Eemac/OlinBAD/Hardware/PowerFet/HIghSidePowerFET.step

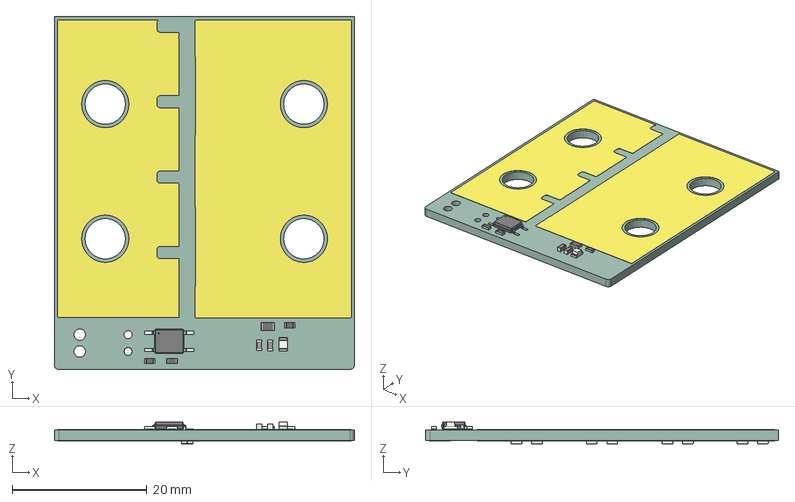
[picture p1: CAD file, 2025-10-27]
Hardware/PowerFet/HIghSidePowerFET.step
44.6 x 52.4 x 3.25 mm
R_0603_1608Metric x 11
R_0805_2012Metric
LED_0805_2012Metric
C_0603_1608Metric x 2
SO_4_44x36mm_P254mm
_autosave-HIghSidePowerFET_zone_1
_autosave-HIghSidePowerFET_zone_2
_autosave-HIghSidePowerFET_zone_3
_autosave-HIghSidePowerFET_zone_4
_autosave-HIghSidePowerFET_zone_5
_autosave-HIghSidePowerFET_PCB
