Eemac/OlinBAD/Hardware/Power Board/Thermistors/Thermistors.kicad_pcb

## KiCad design Hardware/Power Board/Thermistors/Thermistors.kicad_pcb (2025-11-01)

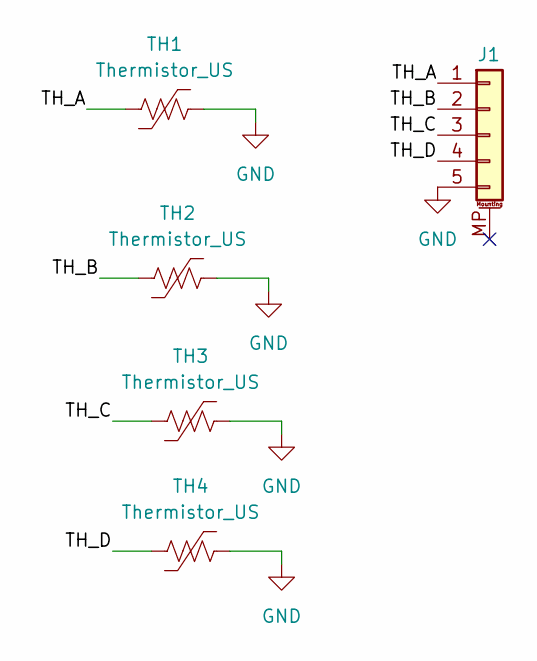
[picture p2: schematic Thermistors.kicad_sch]

Parts:
J1: Conn_01x05_MountingPin; JST_EH_B5B-EH-A_1x05_P2.50mm_Vertical
TH1, TH2, TH3, TH4: Thermistor_US; R_0603_1608Metric

Connections:
/TH_A: J1.1, TH1.1
/TH_B: J1.2, TH2.1
/TH_C: J1.3, TH3.1
/TH_D: J1.4, TH4.1
GND: J1.5, TH1.2, TH2.2, TH3.2, TH4.2

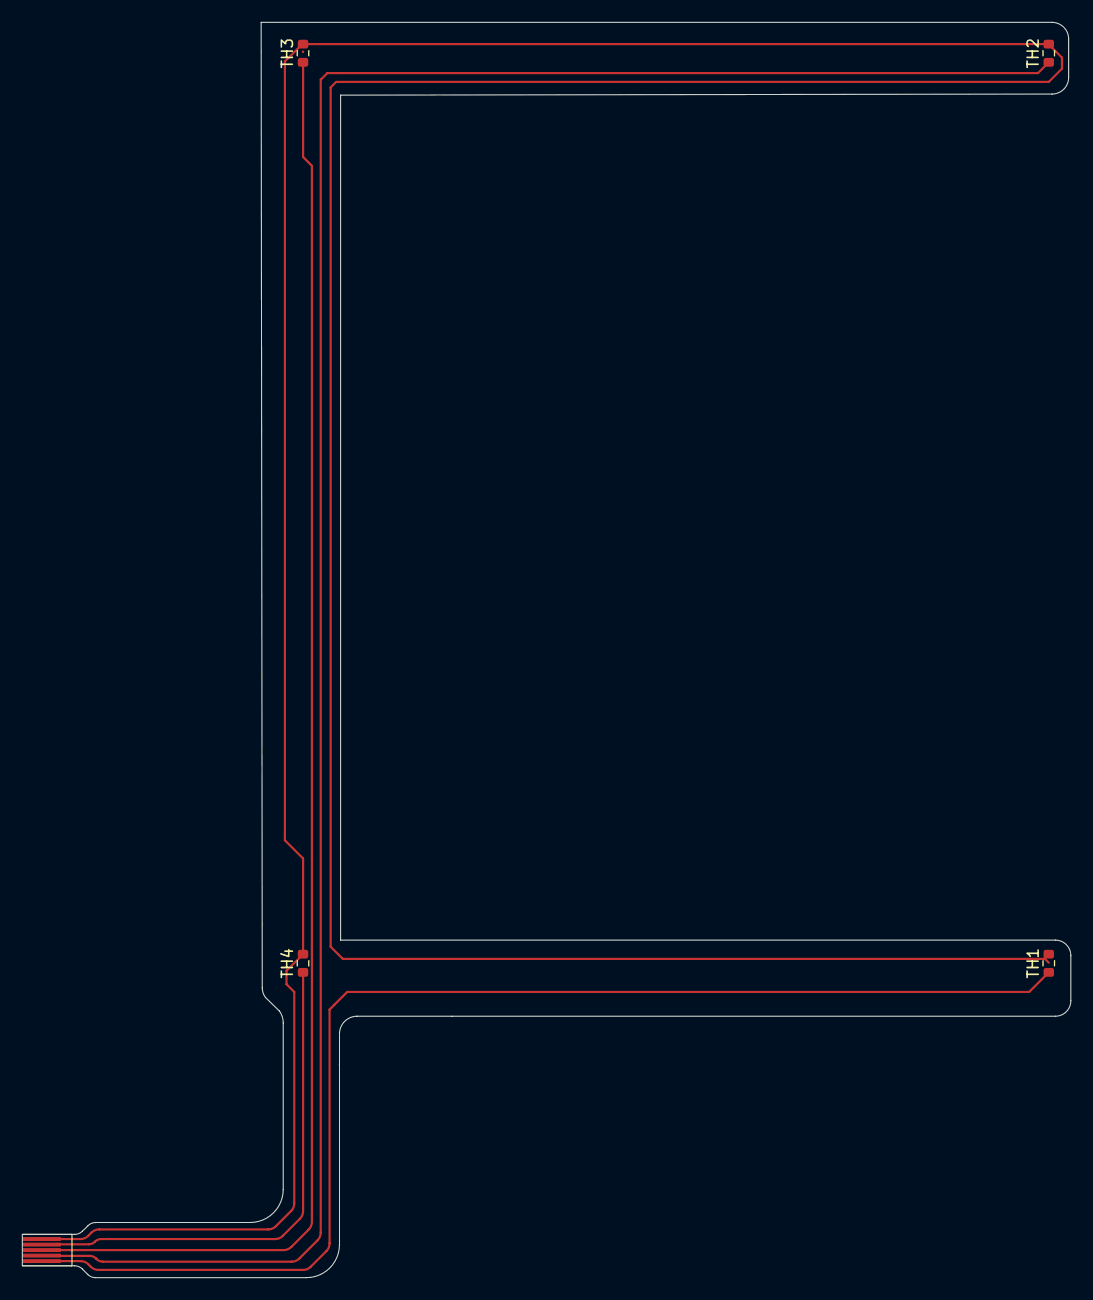
[picture p3: board Thermistors.kicad_pcb from above]

Board: 2 copper layers, 95.0 x 113.8 mm, 5 parts (0 on the bottom side), 5 nets.
