Eemac/OlinBAD/Hardware/BMS/bms.kicad_pcb

## KiCad design Hardware/BMS/bms.kicad_pcb (2025-11-01)

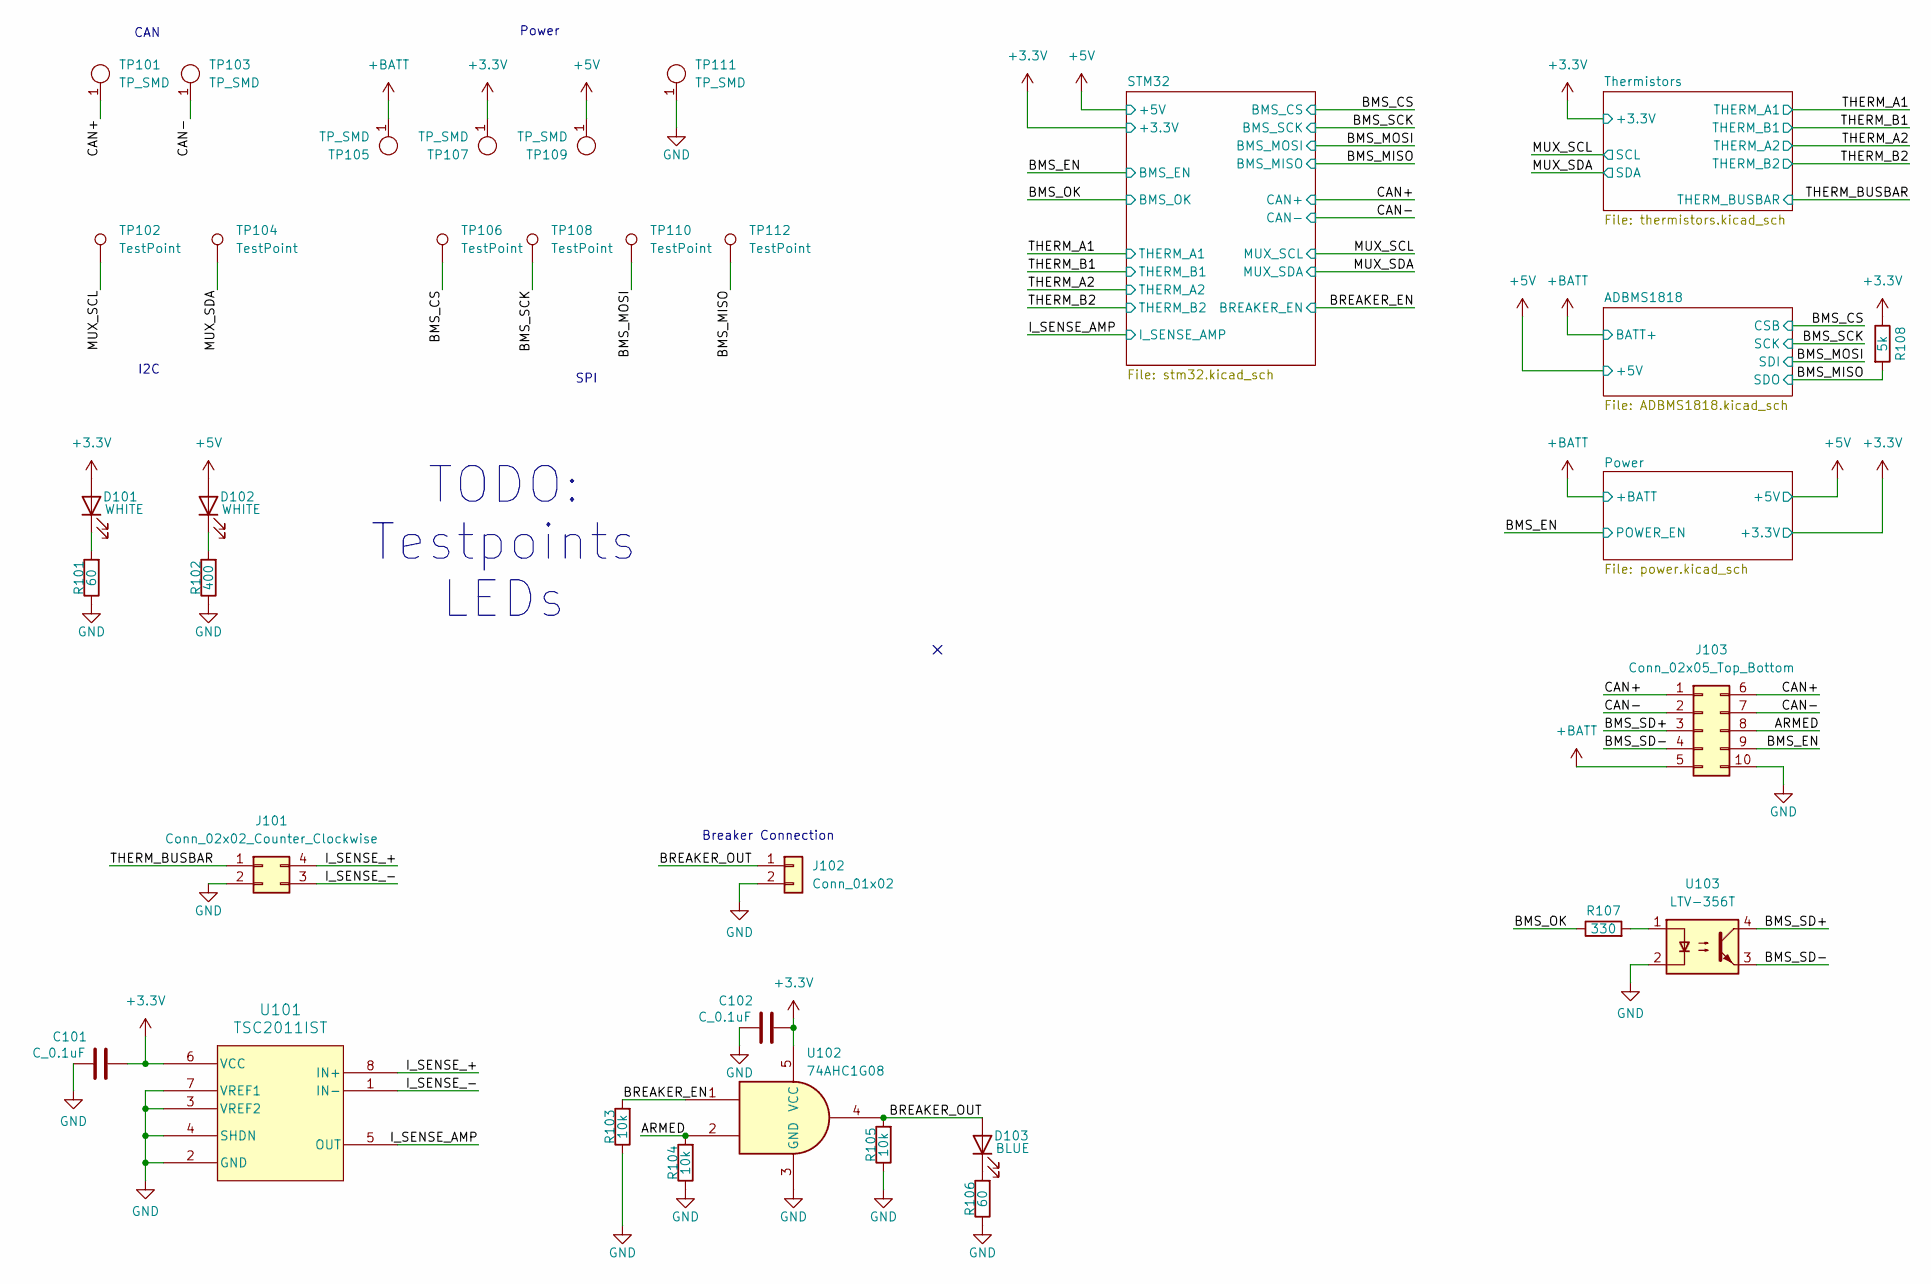
[picture p4: schematic bms.kicad_sch]

Parts:
C101, C102: C_0.1uF; C_0603_1608Metric; MPN 478-3352-1-ND
D101, D102: WHITE; LED_0805_2012Metric
D103: BLUE; LED_0805_2012Metric
J101: Conn_02x02_Counter_Clockwise; Molex_Micro-Fit_3.0_43045-0400_2x02_P3.00mm_Horizontal
J102: Conn_01x02; Molex_Nano-Fit_105313-xx02_1x02_P2.50mm_Horizontal
J103: Conn_02x05_Top_Bottom; Molex_Micro-Fit_3.0_43045-1000_2x05_P3.00mm_Horizontal
R101, R106: 60; R_0603_1608Metric
R102: 400; R_0603_1608Metric
R103, R104, R105: 10k; R_0603_1608Metric
R107: 330; R_0603_1608Metric; MPN RMCF0603FT1K00
R108: 5k; R_0603_1608Metric; MPN RMCF0603FT1K00
TP101, TP103, TP105, TP107, TP109, TP111: TP_SMD; TestPoint_Keystone_5019_Miniature; MPN 5019
TP102, TP104, TP106, TP108, TP110, TP112: TestPoint; TestPoint_Pad_1.0x1.0mm
U101: TSC2011IST; SO_011IST_STM-M
U102: 74AHC1G08; SOT-23-5
U103: LTV-356T; SO-4_4.4x3.6mm_P2.54mm

Connections:
+3.3V: C101.2, C102.2, D101.2 (A), R108.1, TP107.1, U101.6 (VCC), U102.5 (VCC); also elsewhere on the board
+5V: D102.2 (A), TP109.1; also elsewhere on the board
+BATT: J103.5, TP105.1; also elsewhere on the board
/ARMED: J103.8, R104.2, U102.2
/BMS_CS: TP106.1; also elsewhere on the board
/BMS_EN: J103.9; also elsewhere on the board
/BMS_MISO: R108.2, TP112.1; also elsewhere on the board
/BMS_MOSI: TP110.1; also elsewhere on the board
/BMS_OK: R107.1; also elsewhere on the board
/BMS_SCK: TP108.1; also elsewhere on the board
/BMS_SD+: J103.3, U103.4
/BMS_SD-: J103.4, U103.3
/BREAKER_EN: R103.2, U102.1; also elsewhere on the board
/BREAKER_OUT: D103.2 (A), J102.1, R105.2, U102.4
/CAN+: J103.1, J103.6, TP101.1; also elsewhere on the board
/CAN-: J103.2, J103.7, TP103.1; also elsewhere on the board
/I_SENSE_+: J101.4, U101.8 (IN+)
/I_SENSE_-: J101.3, U101.1 (IN-)
/I_SENSE_AMP: U101.5 (OUT); also elsewhere on the board
/MUX_SCL: TP102.1; also elsewhere on the board
/MUX_SDA: TP104.1; also elsewhere on the board
/THERM_BUSBAR: J101.1; also elsewhere on the board
GND: C101.1, C102.1, J101.2, J102.2, J103.10, R101.1, R102.1, R103.1, R104.1, R105.1, R106.1, TP111.1, U101.2 (GND), U101.3 (VREF2), U101.4 (SHDN), U101.7 (VREF1), U102.3 (GND), U103.2; also elsewhere on the board
unnamed: D101.1 (K), R101.2
unnamed: D102.1 (K), R102.2
unnamed: D103.1 (K), R106.2
unnamed: R107.2, U103.1

Notes on the sheet:
I2C
CAN
TODO: Testpoints LEDs
SPI
Breaker Connection
Power

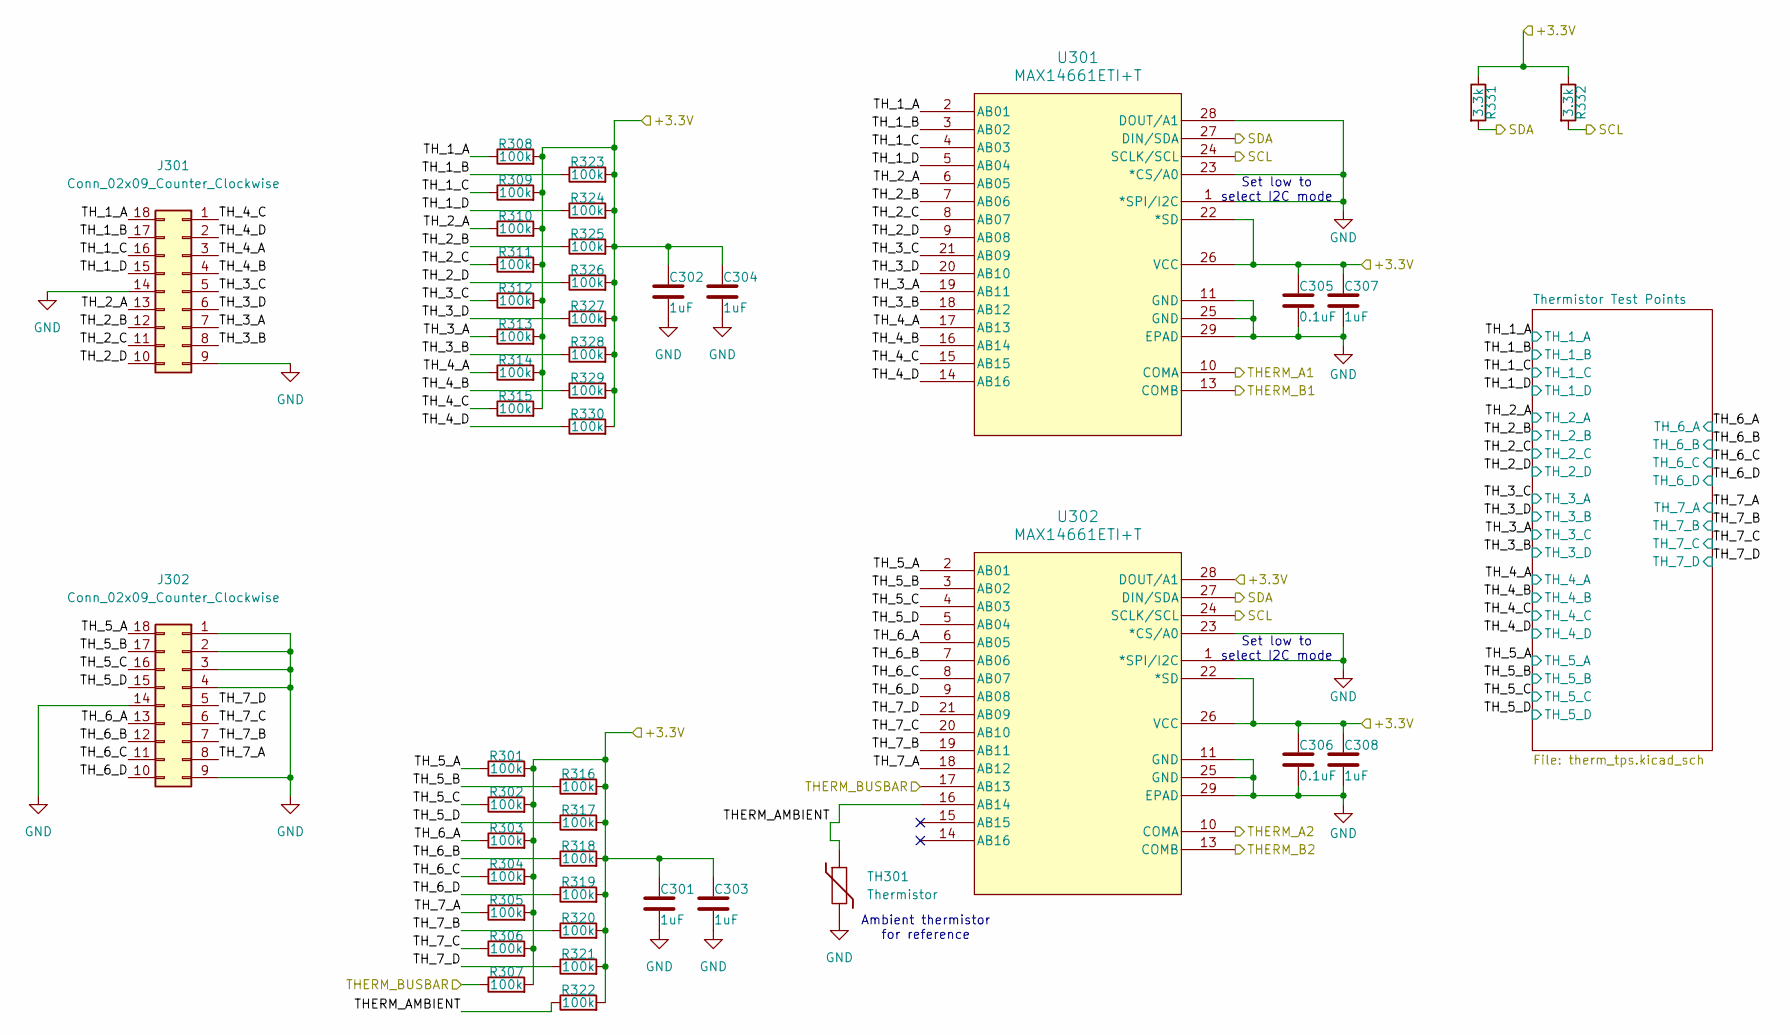
[picture p5: schematic thermistors.kicad_sch]

Parts:
C301, C302, C303, C304, C307, C308: 1uF; C_0603_1608Metric
C305, C306: 0.1uF; C_0603_1608Metric
J301, J302: Conn_02x09_Counter_Clockwise; PinSocket_2x09_P2.54mm_Vertical
R301, R302, R303, R304, R305, R306, R307, R308, R309, R310, R311, R312, R313, R314, R315, R316, R317, R318, R319, R320, R321, R322, R323, R324, R325, R326, R327, R328, R329, R330: 100k; R_0603_1608Metric
R331, R332: 3.3k; R_0603_1608Metric
TH301: Thermistor; R_0603_1608Metric
U301, U302: MAX14661ETI+T; 21-0139I_T2844-1_MXM

Connections:
+3.3V: C301.1, C302.1, C303.1, C304.1, C305.1, C306.1, C307.1, C308.1, R301.2, R302.2, R303.2, R304.2, R305.2, R306.2, R307.2, R308.2, R309.2, R310.2, R311.2, R312.2, R313.2, R314.2, R315.2, R316.2, R317.2, R318.2, R319.2, R320.2, R321.2, R322.2, R323.2, R324.2, R325.2, R326.2, R327.2, R328.2, R329.2, R330.2, R331.1, R332.1, U301.22 (*SD), U301.26 (VCC), U302.22 (*SD), U302.26 (VCC), U302.28 (DOUT/A1); also elsewhere on the board
/MUX_SCL: R332.2, U301.24 (SCLK/SCL), U302.24 (SCLK/SCL); also elsewhere on the board
/MUX_SDA: R331.2, U301.27 (DIN/SDA), U302.27 (DIN/SDA); also elsewhere on the board
/THERM_A1: U301.10 (COMA); also elsewhere on the board
/THERM_A2: U302.10 (COMA); also elsewhere on the board
/THERM_B1: U301.13 (COMB); also elsewhere on the board
/THERM_B2: U302.13 (COMB); also elsewhere on the board
/THERM_BUSBAR: R307.1, U302.17 (AB13); also elsewhere on the board
/Thermistors/THERM_AMBIENT: R322.1, TH301.1, U302.16 (AB14)
/Thermistors/TH_1_A: J301.18, R308.1, U301.2 (AB01); also elsewhere on the board
/Thermistors/TH_1_B: J301.17, R323.1, U301.3 (AB02); also elsewhere on the board
/Thermistors/TH_1_C: J301.16, R309.1, U301.4 (AB03); also elsewhere on the board
/Thermistors/TH_1_D: J301.15, R324.1, U301.5 (AB04); also elsewhere on the board
/Thermistors/TH_2_A: J301.13, R310.1, U301.6 (AB05); also elsewhere on the board
/Thermistors/TH_2_B: J301.12, R325.1, U301.7 (AB06); also elsewhere on the board
/Thermistors/TH_2_C: J301.11, R311.1, U301.8 (AB07); also elsewhere on the board
/Thermistors/TH_2_D: J301.10, R326.1, U301.9 (AB08); also elsewhere on the board
/Thermistors/TH_3_A: J301.7, R313.1, U301.19 (AB11); also elsewhere on the board
/Thermistors/TH_3_B: J301.8, R328.1, U301.18 (AB12); also elsewhere on the board
/Thermistors/TH_3_C: J301.5, R312.1, U301.21 (AB09); also elsewhere on the board
/Thermistors/TH_3_D: J301.6, R327.1, U301.20 (AB10); also elsewhere on the board
/Thermistors/TH_4_A: J301.3, R314.1, U301.17 (AB13); also elsewhere on the board
/Thermistors/TH_4_B: J301.4, R329.1, U301.16 (AB14); also elsewhere on the board
/Thermistors/TH_4_C: J301.1, R315.1, U301.15 (AB15); also elsewhere on the board
/Thermistors/TH_4_D: J301.2, R330.1, U301.14 (AB16); also elsewhere on the board
/Thermistors/TH_5_A: J302.18, R301.1, U302.2 (AB01); also elsewhere on the board
/Thermistors/TH_5_B: J302.17, R316.1, U302.3 (AB02); also elsewhere on the board
/Thermistors/TH_5_C: J302.16, R302.1, U302.4 (AB03); also elsewhere on the board
/Thermistors/TH_5_D: J302.15, R317.1, U302.5 (AB04); also elsewhere on the board
/Thermistors/TH_6_A: J302.13, R303.1, U302.6 (AB05); also elsewhere on the board
/Thermistors/TH_6_B: J302.12, R318.1, U302.7 (AB06); also elsewhere on the board
/Thermistors/TH_6_C: J302.11, R304.1, U302.8 (AB07); also elsewhere on the board
/Thermistors/TH_6_D: J302.10, R319.1, U302.9 (AB08); also elsewhere on the board
/Thermistors/TH_7_A: J302.8, R305.1, U302.18 (AB12); also elsewhere on the board
/Thermistors/TH_7_B: J302.7, R320.1, U302.19 (AB11); also elsewhere on the board
/Thermistors/TH_7_C: J302.6, R306.1, U302.20 (AB10); also elsewhere on the board
/Thermistors/TH_7_D: J302.5, R321.1, U302.21 (AB09); also elsewhere on the board
GND: C301.2, C302.2, C303.2, C304.2, C305.2, C306.2, C307.2, C308.2, J301.9, J301.14, J302.1, J302.2, J302.3, J302.4, J302.9, J302.14, TH301.2, U301.1 (*SPI/I2C), U301.11 (GND), U301.23 (*CS/A0), U301.25 (GND), U301.28 (DOUT/A1), U301.29 (EPAD), U302.1 (*SPI/I2C), U302.11 (GND), U302.23 (*CS/A0), U302.25 (GND), U302.29 (EPAD); also elsewhere on the board

Notes on the sheet:
Set low to select I2C mode
Ambient thermistor for reference

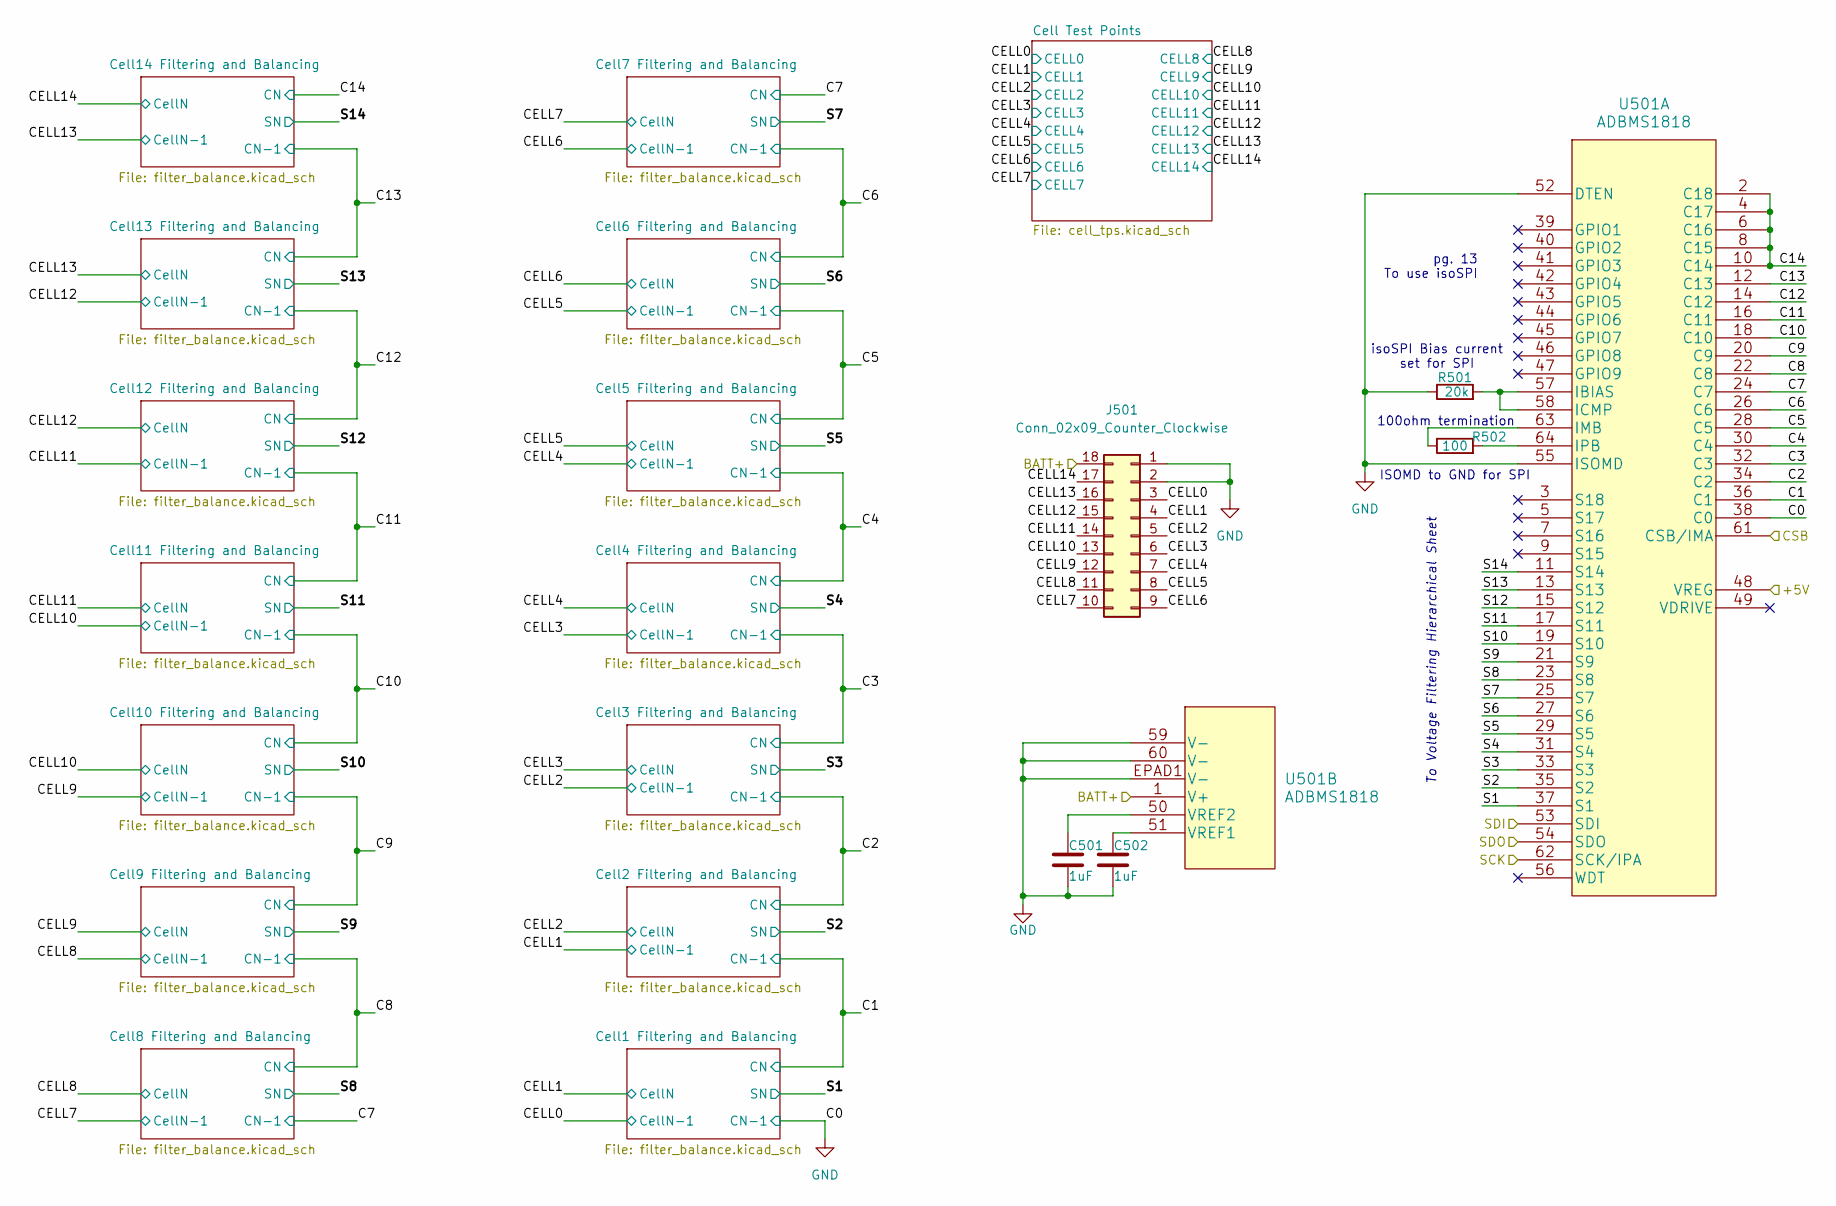
[picture p6: schematic ADBMS1818.kicad_sch]

Parts:
C501, C502: 1uF; C_0603_1608Metric
J501: Conn_02x09_Counter_Clockwise; PinSocket_2x09_P2.54mm_Vertical
R501: 20k; R_0603_1608Metric; MPN RMCF0603FT1K00
R502: 100; R_0603_1608Metric; MPN RMCF0603FT1K00
U501: ADBMS1818; LQFP-64-1EP_12x12_P0.5

Connections:
+5V: U501.48 (VREG); also elsewhere on the board
+BATT: J501.18, U501.1 (V+); also elsewhere on the board
/ADBMS1818/C1: J501.4, U501.36 (C1); also elsewhere on the board
/ADBMS1818/C2: J501.5, U501.34 (C2); also elsewhere on the board
/ADBMS1818/C3: J501.6, U501.32 (C3); also elsewhere on the board
/ADBMS1818/C4: J501.7, U501.30 (C4); also elsewhere on the board
/ADBMS1818/C5: J501.8, U501.28 (C5); also elsewhere on the board
/ADBMS1818/C6: J501.9, U501.26 (C6); also elsewhere on the board
/ADBMS1818/C7: J501.10, U501.24 (C7); also elsewhere on the board
/ADBMS1818/C8: J501.11, U501.22 (C8); also elsewhere on the board
/ADBMS1818/C9: J501.12, U501.20 (C9); also elsewhere on the board
/ADBMS1818/C10: J501.13, U501.18 (C10); also elsewhere on the board
/ADBMS1818/C11: J501.14, U501.16 (C11); also elsewhere on the board
/ADBMS1818/C12: J501.15, U501.14 (C12); also elsewhere on the board
/ADBMS1818/C13: J501.16, U501.12 (C13); also elsewhere on the board
/ADBMS1818/C14: U501.2 (C18), U501.4 (C17), U501.6 (C16), U501.8 (C15), U501.10 (C14); also elsewhere on the board
/ADBMS1818/CELL14: J501.17; also elsewhere on the board
/ADBMS1818/S1: U501.37 (S1); also elsewhere on the board
/ADBMS1818/S2: U501.35 (S2); also elsewhere on the board
/ADBMS1818/S3: U501.33 (S3); also elsewhere on the board
/ADBMS1818/S4: U501.31 (S4); also elsewhere on the board
/ADBMS1818/S5: U501.29 (S5); also elsewhere on the board
/ADBMS1818/S6: U501.27 (S6); also elsewhere on the board
/ADBMS1818/S7: U501.25 (S7); also elsewhere on the board
/ADBMS1818/S8: U501.23 (S8); also elsewhere on the board
/ADBMS1818/S9: U501.21 (S9); also elsewhere on the board
/ADBMS1818/S10: U501.19 (S10); also elsewhere on the board
/ADBMS1818/S11: U501.17 (S11); also elsewhere on the board
/ADBMS1818/S12: U501.15 (S12); also elsewhere on the board
/ADBMS1818/S13: U501.13 (S13); also elsewhere on the board
/ADBMS1818/S14: U501.11 (S14); also elsewhere on the board
/BMS_CS: U501.61 (CSB/IMA); also elsewhere on the board
/BMS_MISO: U501.54 (SDO); also elsewhere on the board
/BMS_MOSI: U501.53 (SDI); also elsewhere on the board
/BMS_SCK: U501.62 (SCK/IPA); also elsewhere on the board
GND: C501.2, C502.2, J501.1, J501.2, J501.3, R501.1, U501.38 (C0), U501.52 (DTEN), U501.55 (ISOMD), U501.59 (V-), U501.60 (V-), U501.EPAD1 (V-); also elsewhere on the board
unnamed: R501.2, U501.57 (IBIAS), U501.58 (ICMP)
unnamed: R502.1, U501.63 (IMB)
unnamed: R502.2, U501.64 (IPB)
unnamed: C502.1, U501.51 (VREF1)
unnamed: C501.1, U501.50 (VREF2)

Notes on the sheet:
100ohm termination
pg. 13 To use isoSPI
ISOMD to GND for SPI
isoSPI Bias current set for SPI
To Voltage Filtering Hierarchical Sheet

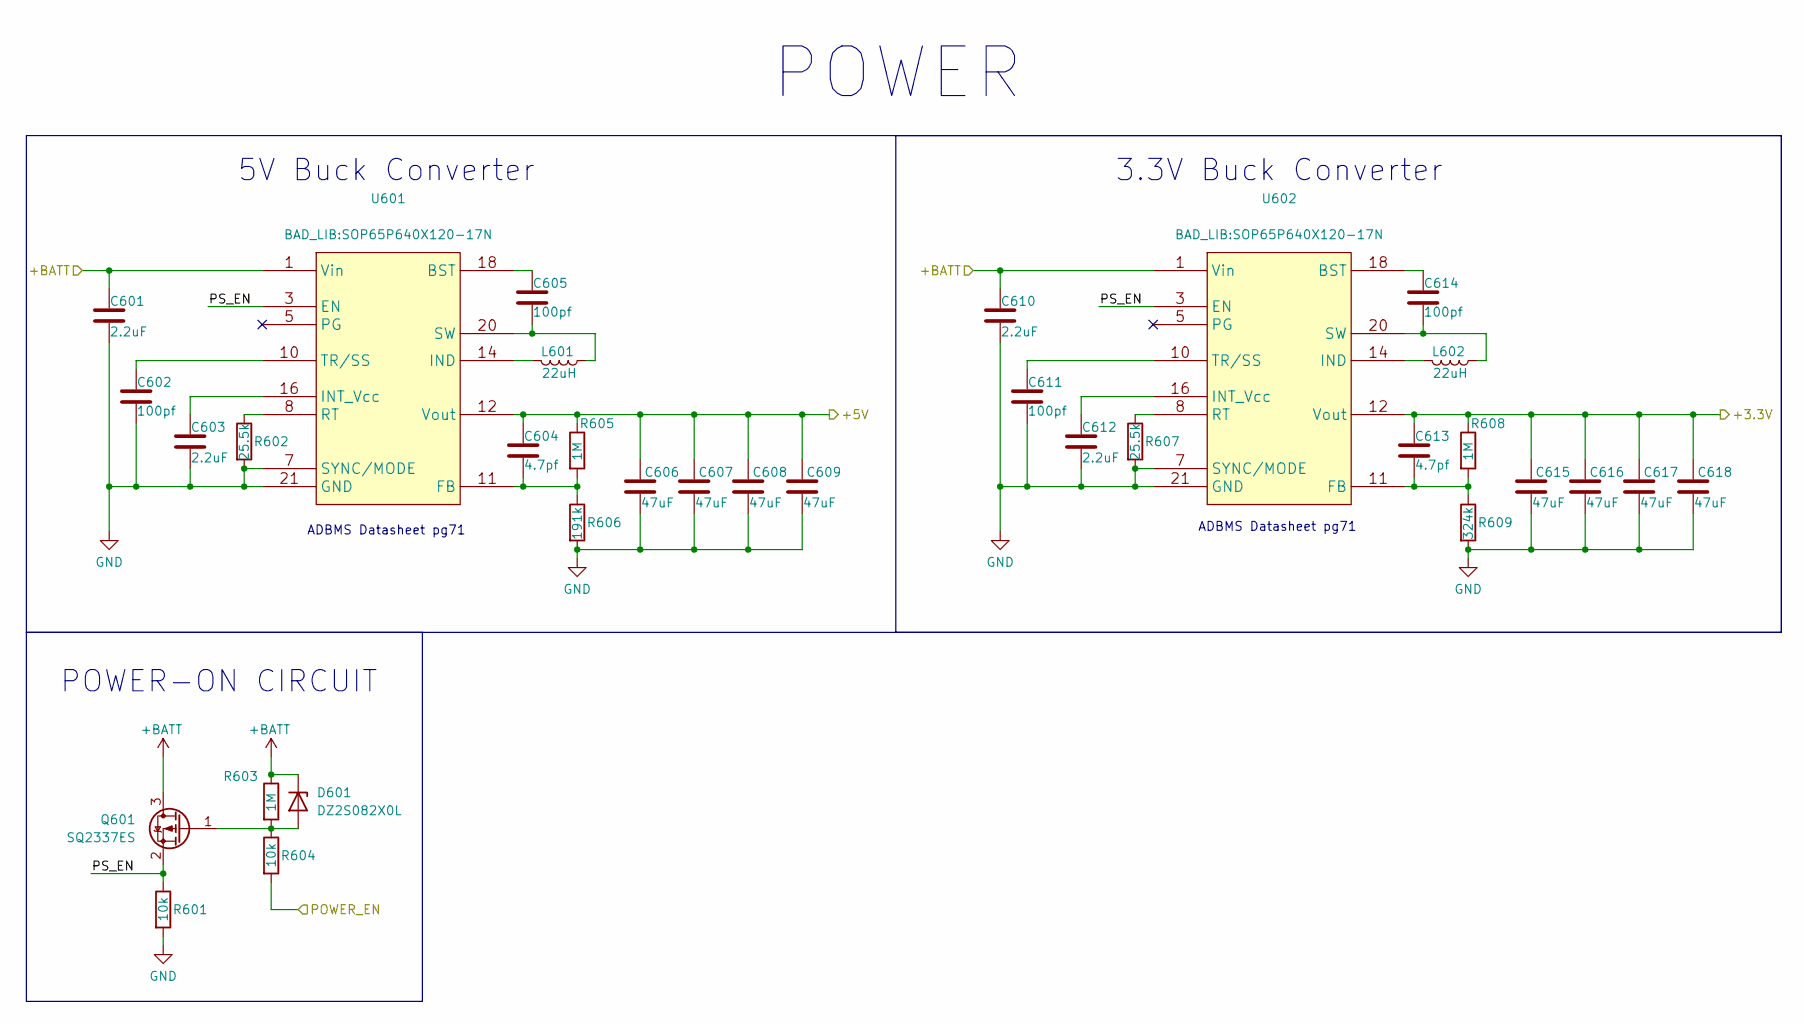
[picture p7: schematic power.kicad_sch]

Parts:
C601, C603, C610, C612: 2.2uF; C_0603_1608Metric
C602, C605, C611, C614: 100pf; C_0603_1608Metric
C604, C613: 4.7pf; C_0603_1608Metric
C606, C607, C608, C609, C615, C616, C617, C618: 47uF; C_1206_3216Metric
D601: DZ2S082X0L; D_SOD-523
L601, L602: 22uH; L_12x12mm_H4.5mm
Q601: SQ2337ES; SOT-23
R601, R604: 10k; R_0603_1608Metric
R602, R607: 25.5k; R_0603_1608Metric
R603, R605, R608: 1M; R_0603_1608Metric
R606: 191k; R_0603_1608Metric
R609: 324k; R_0603_1608Metric
U601, U602: SOP65P640X120-17N

Connections:
+3.3V: C613.1, C615.1, C616.1, C617.1, C618.1, R608.1, U602.12 (Vout); also elsewhere on the board
+5V: C604.1, C606.1, C607.1, C608.1, C609.1, R605.1, U601.12 (Vout); also elsewhere on the board
+BATT: C601.1, C610.1, D601.1 (K), Q601.3 (D), R603.1, U601.1 (Vin), U602.1 (Vin); also elsewhere on the board
/BMS_EN: R604.2; also elsewhere on the board
/Power/PS_EN: Q601.2 (S), R601.1, U601.3 (EN), U602.3 (EN)
GND: C601.2, C602.2, C603.2, C606.2, C607.2, C608.2, C609.2, C610.2, C611.2, C612.2, C615.2, C616.2, C617.2, C618.2, R601.2, R602.2, R606.2, R607.2, R609.2, U601.7 (SYNC/MODE), U601.21 (GND), U602.7 (SYNC/MODE), U602.21 (GND); also elsewhere on the board
unnamed: D601.2 (A), Q601.1 (G), R603.2, R604.1
unnamed: C605.1, U601.18 (BST)
unnamed: C604.2, R605.2, R606.1, U601.11 (FB)
unnamed: L601.2, U601.14 (IND)
unnamed: C603.1, U601.16 (INT_Vcc)
unnamed: R602.1, U601.8 (RT)
unnamed: C605.2, L601.1, U601.20 (SW)
unnamed: C602.1, U601.10 (TR/SS)
unnamed: C614.1, U602.18 (BST)
unnamed: C613.2, R608.2, R609.1, U602.11 (FB)
unnamed: L602.2, U602.14 (IND)
unnamed: C612.1, U602.16 (INT_Vcc)
unnamed: R607.1, U602.8 (RT)
unnamed: C614.2, L602.1, U602.20 (SW)
unnamed: C611.1, U602.10 (TR/SS)

Notes on the sheet:
3.3V Buck Converter
ADBMS Datasheet pg71
POWER-ON CIRCUIT
5V Buck Converter
POWER

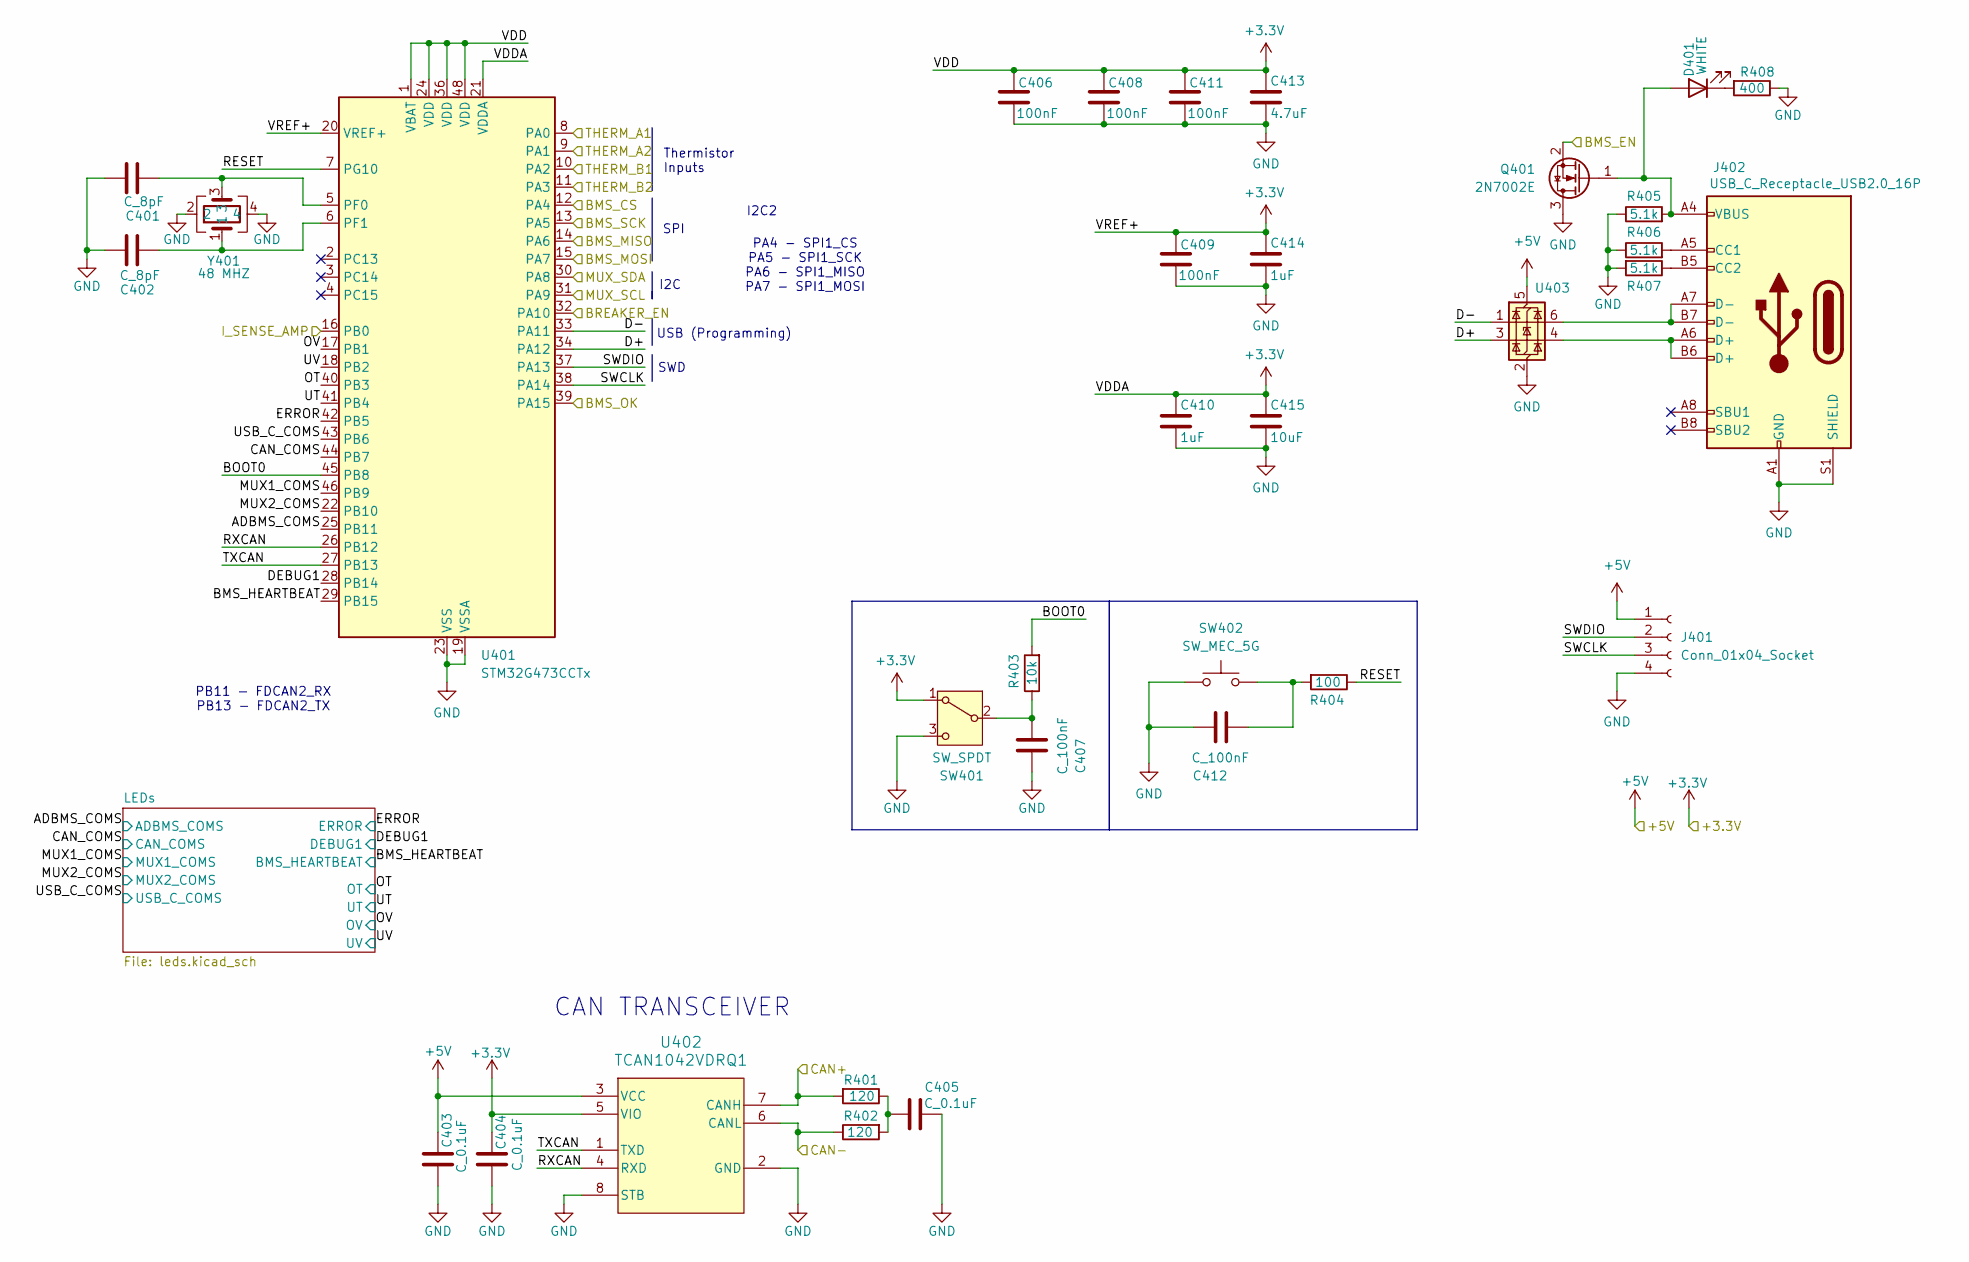
[picture p8: schematic stm32.kicad_sch]

Parts:
C401, C402: C_8pF; C_0603_1608Metric; MPN 1276-6717-1-ND
C403, C404, C405: C_0.1uF; C_0603_1608Metric; MPN 478-3352-1-ND
C406, C408, C409, C411: 100nF; C_0603_1608Metric; MPN 1276-6717-1-ND
C407, C412: C_100nF; C_0603_1608Metric; MPN 1276-6717-1-ND
C410, C414: 1uF; C_0603_1608Metric; MPN 1276-1052-1-ND
C413: 4.7uF; C_0805_2012Metric; MPN 1276-1052-1-ND
C415: 10uF; C_0805_2012Metric; MPN 1276-1052-1-ND
D401: WHITE; LED_0805_2012Metric
J401: Conn_01x04_Socket; PinSocket_1x04_P2.54mm_Vertical
J402: USB_C_Receptacle_USB2.0_16P; USB_C_Receptacle_G-Switch_GT-USB-7051x
Q401: 2N7002E; SOT-23
R401, R402: 120; R_0603_1608Metric; MPN 667-ERJ-6ENF1200V
R403: 10k; R_0805_OEM; MPN CRS0805-FX-1002ELFCT-ND
R404: 100; R_0805_OEM; MPN CRS0805-FX-1002ELFCT-ND
R405, R406, R407: 5.1k; R_0603_1608Metric; MPN RMCF0603FT1K00
R408: 400; R_0603_1608Metric
SW401: SW_SPDT; SW_SPDT_Shouhan_MSK12C02
SW402: SW_MEC_5G; SW_MEC_5GSH9
U401: STM32G473CCTx; LQFP-48_7x7mm_P0.5mm
U402: TCAN1042VDRQ1; D0008A_M
U403: USBLC6-2SC6; SOT-23-6
Y401: 48 MHZ; Crystal_SMD_FA238; MPN 7M48072002

Connections:
+3.3V: C404.1, C406.1, C408.1, C409.1, C410.1, C411.1, C413.1, C414.1, C415.1, SW401.1 (A), U401.1 (VBAT), U401.20 (VREF+), U401.21 (VDDA), U401.24 (VDD), U401.36 (VDD), U401.48 (VDD), U402.5 (VIO); also elsewhere on the board
+5V: C403.1, J401.1, U402.3 (VCC), U403.5 (VBUS); also elsewhere on the board
/BMS_CS: U401.12 (PA4); also elsewhere on the board
/BMS_EN: Q401.2 (S); also elsewhere on the board
/BMS_MISO: U401.14 (PA6); also elsewhere on the board
/BMS_MOSI: U401.15 (PA7); also elsewhere on the board
/BMS_OK: U401.39 (PA15); also elsewhere on the board
/BMS_SCK: U401.13 (PA5); also elsewhere on the board
/BREAKER_EN: U401.32 (PA10); also elsewhere on the board
/CAN+: R401.2, U402.7 (CANH); also elsewhere on the board
/CAN-: R402.1, U402.6 (CANL); also elsewhere on the board
/I_SENSE_AMP: U401.16 (PB0); also elsewhere on the board
/MUX_SCL: U401.31 (PA9); also elsewhere on the board
/MUX_SDA: U401.30 (PA8); also elsewhere on the board
/STM32/ADBMS_COMS: U401.25 (PB11); also elsewhere on the board
/STM32/BMS_HEARTBEAT: U401.29 (PB15); also elsewhere on the board
/STM32/BOOT0: R403.2, U401.45 (PB8)
/STM32/CAN_COMS: U401.44 (PB7); also elsewhere on the board
/STM32/D+: U401.34 (PA12), U403.3 (I/O2)
/STM32/D-: U401.33 (PA11), U403.1 (I/O1)
/STM32/DEBUG1: U401.28 (PB14); also elsewhere on the board
/STM32/ERROR: U401.42 (PB5); also elsewhere on the board
/STM32/MUX1_COMS: U401.46 (PB9); also elsewhere on the board
/STM32/MUX2_COMS: U401.22 (PB10); also elsewhere on the board
/STM32/OT: U401.40 (PB3); also elsewhere on the board
/STM32/OV: U401.17 (PB1); also elsewhere on the board
/STM32/RESET: R404.1, U401.7 (PG10)
/STM32/RXCAN: U401.26 (PB12), U402.4 (RXD)
/STM32/SWCLK: J401.3, U401.38 (PA14)
/STM32/SWDIO: J401.2, U401.37 (PA13)
/STM32/TXCAN: U401.27 (PB13), U402.1 (TXD)
/STM32/USB_C_COMS: U401.43 (PB6); also elsewhere on the board
/STM32/UT: U401.41 (PB4); also elsewhere on the board
/STM32/UV: U401.18 (PB2); also elsewhere on the board
/THERM_A1: U401.8 (PA0); also elsewhere on the board
/THERM_A2: U401.9 (PA1); also elsewhere on the board
/THERM_B1: U401.10 (PA2); also elsewhere on the board
/THERM_B2: U401.11 (PA3); also elsewhere on the board
GND: C401.2, C402.1, C403.2, C404.2, C405.2, C406.2, C407.1, C408.2, C409.2, C410.2, C411.2, C412.1, C413.2, C414.2, C415.2, J401.4, J402.A1 (GND), J402.A12 (GND), J402.B1 (GND), J402.B12 (GND), J402.S1 (SHIELD), Q401.3 (D), R405.1, R406.1, R407.2, R408.1, SW401.3 (C), SW402.1 (A), SW402.2 (A), U401.19 (VSSA), U401.23 (VSS), U401.35 (VSS), U401.47 (VSS), U402.2 (GND), U402.8 (STB), U403.2 (GND), Y401.2, Y401.4; also elsewhere on the board
unnamed: C405.1, R401.1, R402.2
unnamed: C412.2, R404.2, SW402.3 (B), SW402.4 (B)
unnamed: D401.2 (A), J402.A4 (VBUS), J402.A9 (VBUS), J402.B4 (VBUS), J402.B9 (VBUS), Q401.1 (G), R405.2
unnamed: D401.1 (K), R408.2
unnamed: J402.A5 (CC1), R406.2
unnamed: J402.B5 (CC2), R407.1
unnamed: J402.A6 (D+), J402.B6 (D+), U403.4 (I/O2)
unnamed: J402.A7 (D-), J402.B7 (D-), U403.6 (I/O1)
unnamed: C407.2, R403.1, SW401.2 (B)
unnamed: C401.1, U401.5 (PF0), Y401.3
unnamed: C402.2, U401.6 (PF1), Y401.1

Notes on the sheet:
I2C
PA4 - SPI1_CS PA5 - SPI1_SCK PA6 - SPI1_MISO PA7 - SPI1_MOSI
CAN TRANSCEIVER
SWD
SPI
USB (Programming)
I2C2
PB11 - FDCAN2_RX PB13 - FDCAN2_TX
Thermistor Inputs
