Eemac/OlinBAD/Hardware/BMS/bms.kicad_pcb

## KiCad design Hardware/BMS/bms.kicad_pcb (continued)

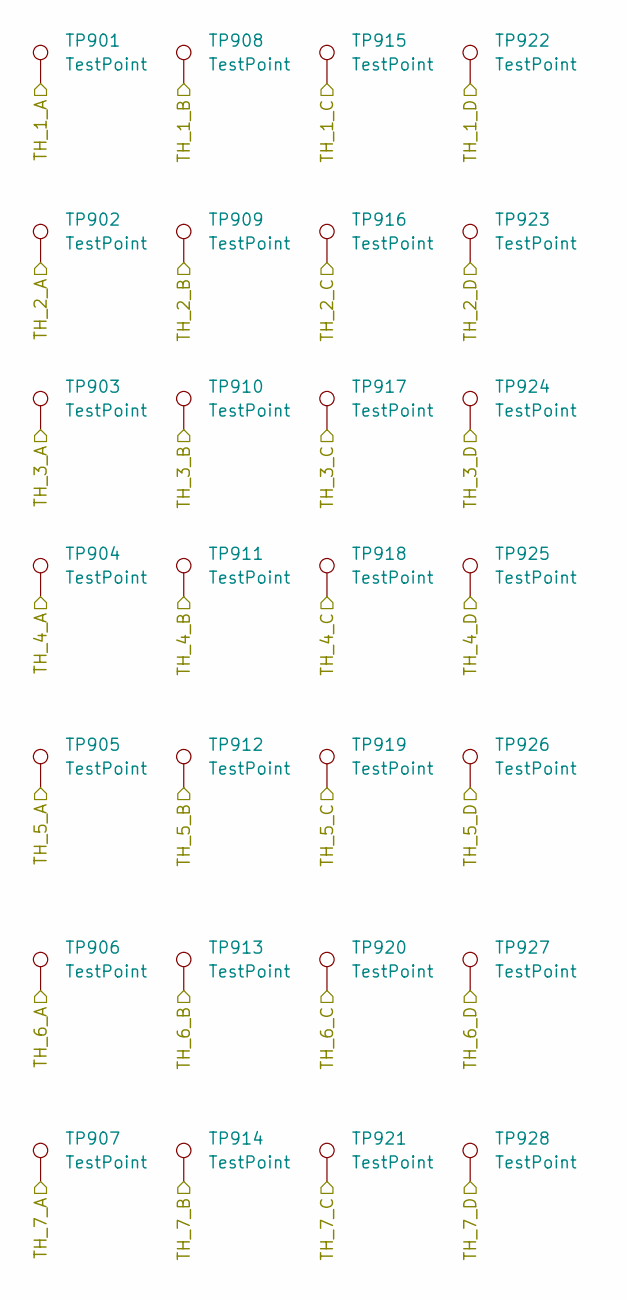
[picture p9: schematic therm_tps.kicad_sch]

Parts:
TP901, TP902, TP903, TP904, TP905, TP906, TP907, TP908, TP909, TP910, TP911, TP912, TP913, TP914, TP915, TP916, TP917, TP918, TP919, TP920, TP921, TP922, TP923, TP924, TP925, TP926, TP927, TP928: TestPoint; TestPoint_Pad_1.0x1.0mm

Connections:
/Thermistors/TH_1_A: TP901.1; also elsewhere on the board
/Thermistors/TH_1_B: TP908.1; also elsewhere on the board
/Thermistors/TH_1_C: TP915.1; also elsewhere on the board
/Thermistors/TH_1_D: TP922.1; also elsewhere on the board
/Thermistors/TH_2_A: TP902.1; also elsewhere on the board
/Thermistors/TH_2_B: TP909.1; also elsewhere on the board
/Thermistors/TH_2_C: TP916.1; also elsewhere on the board
/Thermistors/TH_2_D: TP923.1; also elsewhere on the board
/Thermistors/TH_3_A: TP917.1; also elsewhere on the board
/Thermistors/TH_3_B: TP924.1; also elsewhere on the board
/Thermistors/TH_3_C: TP903.1; also elsewhere on the board
/Thermistors/TH_3_D: TP910.1; also elsewhere on the board
/Thermistors/TH_4_A: TP904.1; also elsewhere on the board
/Thermistors/TH_4_B: TP911.1; also elsewhere on the board
/Thermistors/TH_4_C: TP918.1; also elsewhere on the board
/Thermistors/TH_4_D: TP925.1; also elsewhere on the board
/Thermistors/TH_5_A: TP905.1; also elsewhere on the board
/Thermistors/TH_5_B: TP912.1; also elsewhere on the board
/Thermistors/TH_5_C: TP919.1; also elsewhere on the board
/Thermistors/TH_5_D: TP926.1; also elsewhere on the board
/Thermistors/TH_6_A: TP906.1; also elsewhere on the board
/Thermistors/TH_6_B: TP913.1; also elsewhere on the board
/Thermistors/TH_6_C: TP920.1; also elsewhere on the board
/Thermistors/TH_6_D: TP927.1; also elsewhere on the board
/Thermistors/TH_7_A: TP907.1; also elsewhere on the board
/Thermistors/TH_7_B: TP914.1; also elsewhere on the board
/Thermistors/TH_7_C: TP921.1; also elsewhere on the board
/Thermistors/TH_7_D: TP928.1; also elsewhere on the board

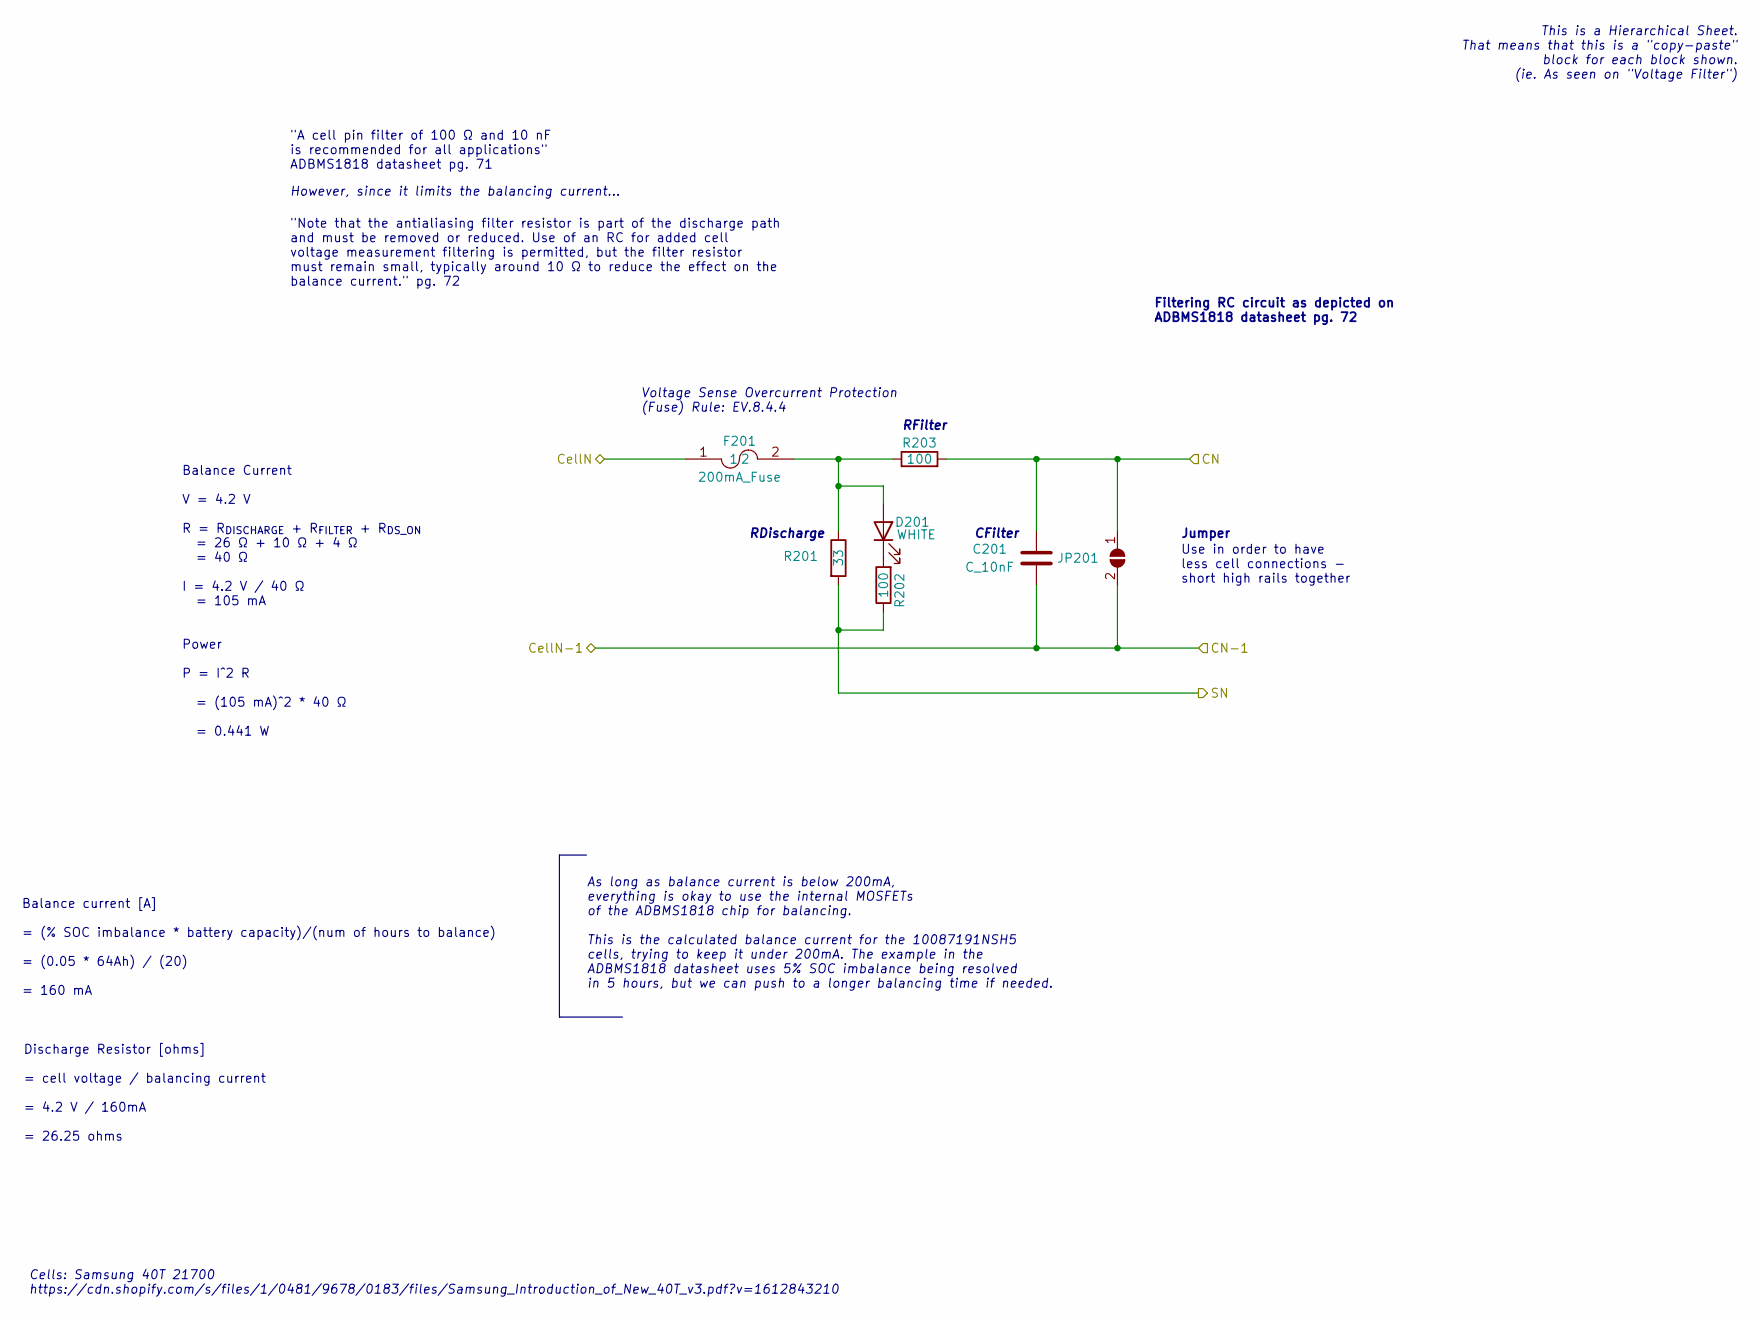
[picture p10: schematic filter_balance.kicad_sch]

Parts:
C201: C_10nF; C_0603_1608Metric; MPN CL10B103KB8NNNC
D201: WHITE; LED_0805_2012Metric
F201: 200mA_Fuse; Fuse_1206_3216Metric; MPN 0466.200NRHF
JP201: SolderJumper_2_Open; SolderJumper-2_P1.3mm_Open_TrianglePad1.0x1.5mm
R201: 33; R_2512_6332Metric; MPN 352022RJT
R202: 100; R_0603_1608Metric
R203: 100; R_0603_1608Metric; MPN SG73P1JTTD100J

Connections:
/ADBMS1818/C1: C201.1, F201.1, JP201.1 (A), R203.2; also elsewhere on the board
/ADBMS1818/S1: R201.2, R202.1; also elsewhere on the board
GND: C201.2, JP201.2 (B); also elsewhere on the board
unnamed: D201.2 (A), F201.2, R201.1, R203.1
unnamed: D201.1 (K), R202.2

Parts of its further copies:
C701, C1001, C1201, C1301, C1401, C1501, C1601, C1701, C1801, C1901, C2001, C2101, C2201: C_10nF; C_0603_1608Metric; MPN CL10B103KB8NNNC
D701, D1001, D1201, D1301, D1401, D1501, D1601, D1701, D1801, D1901, D2001, D2101, D2201: WHITE; LED_0805_2012Metric
F701, F1001, F1201, F1301, F1401, F1501, F1601, F1701, F1801, F1901, F2001, F2101, F2201: 200mA_Fuse; Fuse_1206_3216Metric; MPN 0466.200NRHF
JP701, JP1001, JP1201, JP1301, JP1401, JP1501, JP1601, JP1701, JP1801, JP1901, JP2001, JP2101, JP2201: SolderJumper_2_Open; SolderJumper-2_P1.3mm_Open_TrianglePad1.0x1.5mm
R701, R1001, R1201, R1301, R1401, R1501, R1601, R1701, R1801, R1901, R2001, R2101, R2201: 33; R_2512_6332Metric; MPN 352022RJT
R702, R1002, R1202, R1302, R1402, R1502, R1602, R1702, R1802, R1902, R2002, R2102, R2202: 100; R_0603_1608Metric
R703, R1003, R1203, R1303, R1403, R1503, R1603, R1703, R1803, R1903, R2003, R2103, R2203: 100; R_0603_1608Metric; MPN SG73P1JTTD100J

Connections of its further copies:
/ADBMS1818/C1: C701.2, JP701.2 (B); also elsewhere on the board
/ADBMS1818/C2: C701.1, C1001.2, F701.1, JP701.1 (A), JP1001.2 (B), R703.2; also elsewhere on the board
/ADBMS1818/C3: C1001.1, C1201.2, F1001.1, JP1001.1 (A), JP1201.2 (B), R1003.2; also elsewhere on the board
/ADBMS1818/C4: C1201.1, C1301.2, F1201.1, JP1201.1 (A), JP1301.2 (B), R1203.2; also elsewhere on the board
/ADBMS1818/C5: C1301.1, C1401.2, F1301.1, JP1301.1 (A), JP1401.2 (B), R1303.2; also elsewhere on the board
/ADBMS1818/C6: C1401.1, C1501.2, F1401.1, JP1401.1 (A), JP1501.2 (B), R1403.2; also elsewhere on the board
/ADBMS1818/C7: C1501.1, C1601.2, F1501.1, JP1501.1 (A), JP1601.2 (B), R1503.2; also elsewhere on the board
/ADBMS1818/C8: C1601.1, C1701.2, F1601.1, JP1601.1 (A), JP1701.2 (B), R1603.2; also elsewhere on the board
/ADBMS1818/C9: C1701.1, C1801.2, F1701.1, JP1701.1 (A), JP1801.2 (B), R1703.2; also elsewhere on the board
/ADBMS1818/C10: C1801.1, C1901.2, F1801.1, JP1801.1 (A), JP1901.2 (B), R1803.2; also elsewhere on the board
/ADBMS1818/C11: C1901.1, C2001.2, F1901.1, JP1901.1 (A), JP2001.2 (B), R1903.2; also elsewhere on the board
/ADBMS1818/C12: C2001.1, C2101.2, F2001.1, JP2001.1 (A), JP2101.2 (B), R2003.2; also elsewhere on the board
/ADBMS1818/C13: C2101.1, C2201.2, F2101.1, JP2101.1 (A), JP2201.2 (B), R2103.2; also elsewhere on the board
/ADBMS1818/C14: C2201.1, JP2201.1 (A), R2203.2; also elsewhere on the board
/ADBMS1818/CELL14: F2201.1; also elsewhere on the board
/ADBMS1818/S2: R701.2, R702.1; also elsewhere on the board
/ADBMS1818/S3: R1001.2, R1002.1; also elsewhere on the board
/ADBMS1818/S4: R1201.2, R1202.1; also elsewhere on the board
/ADBMS1818/S5: R1301.2, R1302.1; also elsewhere on the board
/ADBMS1818/S6: R1401.2, R1402.1; also elsewhere on the board
/ADBMS1818/S7: R1501.2, R1502.1; also elsewhere on the board
/ADBMS1818/S8: R1601.2, R1602.1; also elsewhere on the board
/ADBMS1818/S9: R1701.2, R1702.1; also elsewhere on the board
/ADBMS1818/S10: R1801.2, R1802.1; also elsewhere on the board
/ADBMS1818/S11: R1901.2, R1902.1; also elsewhere on the board
/ADBMS1818/S12: R2001.2, R2002.1; also elsewhere on the board
/ADBMS1818/S13: R2101.2, R2102.1; also elsewhere on the board
/ADBMS1818/S14: R2201.2, R2202.1; also elsewhere on the board
unnamed: D701.2 (A), F701.2, R701.1, R703.1
unnamed: D701.1 (K), R702.2
unnamed: D1001.2 (A), F1001.2, R1001.1, R1003.1
unnamed: D1001.1 (K), R1002.2
unnamed: D1201.2 (A), F1201.2, R1201.1, R1203.1
unnamed: D1201.1 (K), R1202.2
unnamed: D1301.2 (A), F1301.2, R1301.1, R1303.1
unnamed: D1301.1 (K), R1302.2
unnamed: D1401.2 (A), F1401.2, R1401.1, R1403.1
unnamed: D1401.1 (K), R1402.2
unnamed: D1501.2 (A), F1501.2, R1501.1, R1503.1
unnamed: D1501.1 (K), R1502.2
unnamed: D1601.2 (A), F1601.2, R1601.1, R1603.1
unnamed: D1601.1 (K), R1602.2
unnamed: D1701.2 (A), F1701.2, R1701.1, R1703.1
unnamed: D1701.1 (K), R1702.2
unnamed: D1801.2 (A), F1801.2, R1801.1, R1803.1
unnamed: D1801.1 (K), R1802.2
unnamed: D1901.2 (A), F1901.2, R1901.1, R1903.1
unnamed: D1901.1 (K), R1902.2
unnamed: D2001.2 (A), F2001.2, R2001.1, R2003.1
unnamed: D2001.1 (K), R2002.2
unnamed: D2101.2 (A), F2101.2, R2101.1, R2103.1
unnamed: D2101.1 (K), R2102.2
unnamed: D2201.2 (A), F2201.2, R2201.1, R2203.1
unnamed: D2201.1 (K), R2202.2

Notes on the sheet:
Filtering RC circuit as depicted on ADBMS1818 datasheet pg. 72
"A cell pin filter of 100 Ω and 10 nF is recommended for all applications" ADBMS1818 datasheet pg. 71
Cells: Samsung 40T 21700 https://cdn.shopify.com/s/files/1/0481/9678/0183/files/Samsung_Introduction_of_New_40T_v3.pdf?v=1612843210
Balance current [A] = (% SOC imbalance * battery capacity)/(num of hours to balance) = (0.05 * 64Ah) / (20) = 160 mA
RFilter
Discharge Resistor [ohms] = cell voltage / balancing current = 4.2 V / 160mA = 26.25 ohms
Use in order to have less cell connections - short high rails together
"Note that the antialiasing filter resistor is part of the discharge path and must be removed or reduced. Use of an RC for added cell voltage measurement filtering is permitted, but the filter resistor must remain small, typically around 10 Ω to reduce the effect on the balance current." pg. 72
However, since it limits the balancing current...
RDischarge
Balance Current V = 4.2 V R = R_{DISCHARGE} + R_{FILTER} + R_{DS_ON} = 26 Ω + 10 Ω + 4 Ω = 40 Ω I = 4.2 V / 40 Ω = 105 mA Power P = I^2 R = (105 mA)^2 * 40 Ω = 0.441 W
As long as balance current is below 200mA, everything is okay to use the internal MOSFETs of the ADBMS1818 chip for balancing. This is the calculated balance current for the 10087191NSH5 cells, trying to keep it under 200mA. The example in the ADBMS1818 datasheet uses 5% SOC imbalance being resolve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
This is a Hierarchical Sheet. That means that this is a "copy-paste" block for each block shown. (ie. As seen on "Voltage Filter")
CFilter
Voltage Sense Overcurrent Protection (Fuse) Rule: EV.8.4.4
Jumper

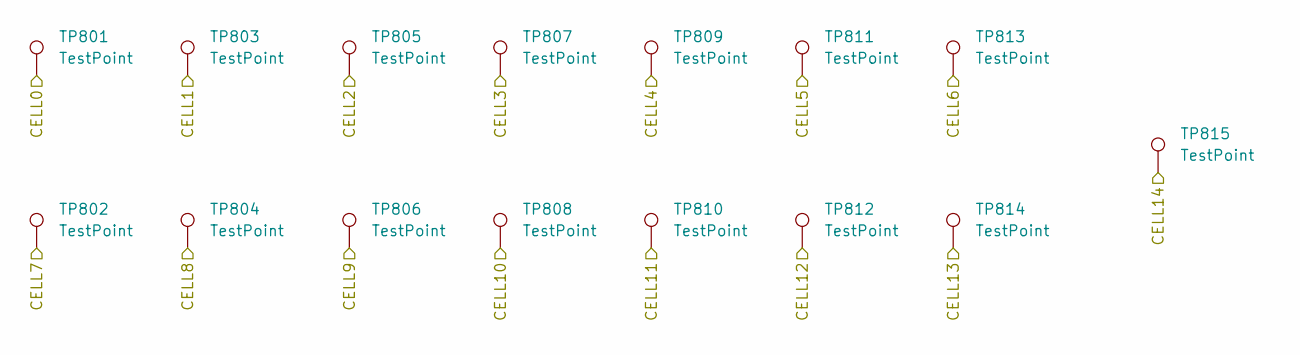
[picture p11: schematic cell_tps.kicad_sch]

Parts:
TP801, TP802, TP803, TP804, TP805, TP806, TP807, TP808, TP809, TP810, TP811, TP812, TP813, TP814, TP815: TestPoint; TestPoint_Pad_1.0x1.0mm

Connections:
/ADBMS1818/C1: TP803.1; also elsewhere on the board
/ADBMS1818/C2: TP805.1; also elsewhere on the board
/ADBMS1818/C3: TP807.1; also elsewhere on the board
/ADBMS1818/C4: TP809.1; also elsewhere on the board
/ADBMS1818/C5: TP811.1; also elsewhere on the board
/ADBMS1818/C6: TP813.1; also elsewhere on the board
/ADBMS1818/C7: TP802.1; also elsewhere on the board
/ADBMS1818/C8: TP804.1; also elsewhere on the board
/ADBMS1818/C9: TP806.1; also elsewhere on the board
/ADBMS1818/C10: TP808.1; also elsewhere on the board
/ADBMS1818/C11: TP810.1; also elsewhere on the board
/ADBMS1818/C12: TP812.1; also elsewhere on the board
/ADBMS1818/C13: TP814.1; also elsewhere on the board
/ADBMS1818/CELL14: TP815.1; also elsewhere on the board
GND: TP801.1; also elsewhere on the board

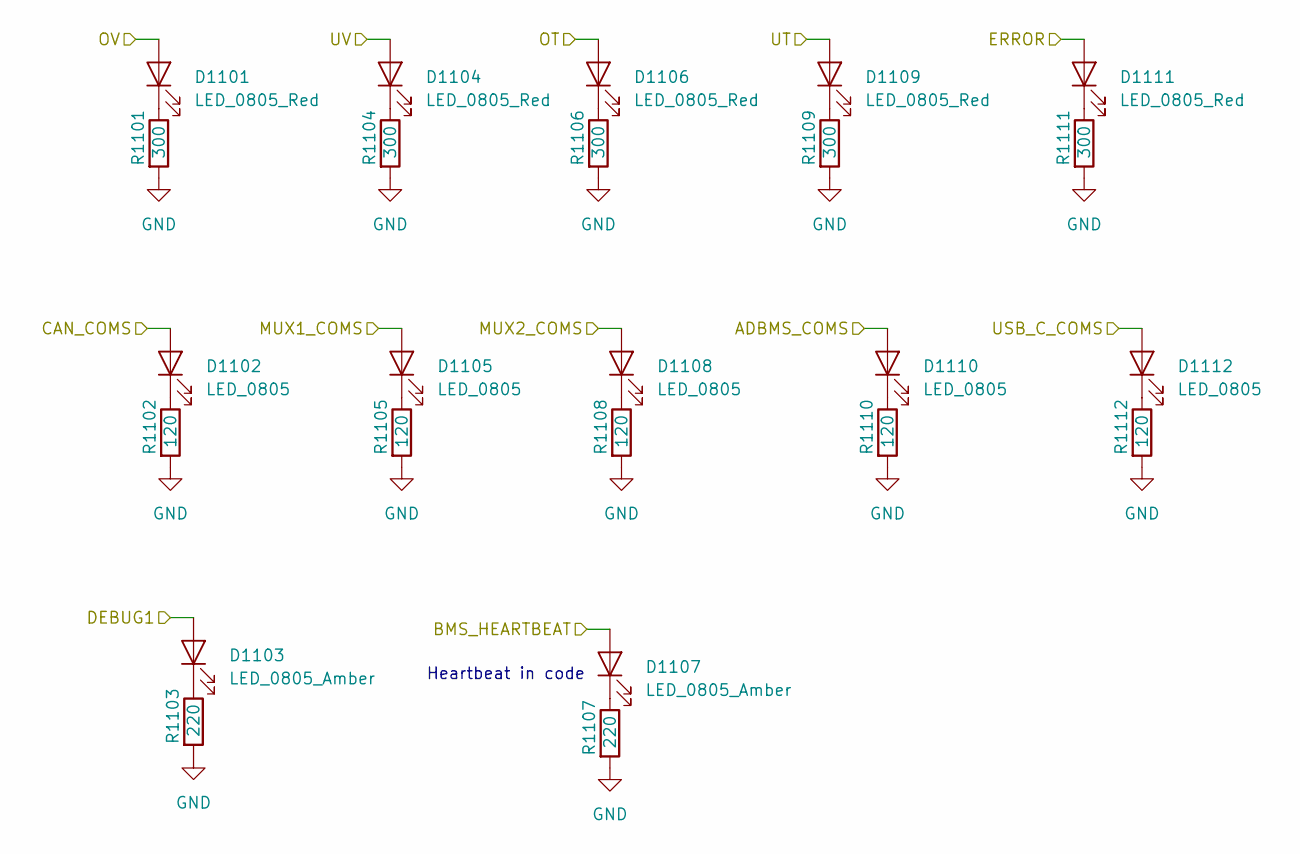
[picture p12: schematic leds.kicad_sch]

Parts:
D1101, D1104, D1106, D1109, D1111: LED_0805_Red; LED_0805_OEM; MPN 475-1415-1-ND
D1102, D1105, D1108, D1110, D1112: LED_0805; LED_0805_OEM; MPN 475-1410-1-ND
D1103, D1107: LED_0805_Amber; LED_0805_OEM; MPN L71517CT-ND
R1101, R1104, R1106, R1109, R1111: 300; R_0603_1608Metric; MPN 667-ERJ-6ENF1200V
R1102, R1105, R1108, R1110, R1112: 120; R_0603_1608Metric; MPN 667-ERJ-6ENF1200V
R1103, R1107: 220; R_0603_1608Metric; MPN 667-ERJ-6ENF1200V

Connections:
/STM32/ADBMS_COMS: D1110.2 (A); also elsewhere on the board
/STM32/BMS_HEARTBEAT: D1107.2 (A); also elsewhere on the board
/STM32/CAN_COMS: D1102.2 (A); also elsewhere on the board
/STM32/DEBUG1: D1103.2 (A); also elsewhere on the board
/STM32/ERROR: D1111.2 (A); also elsewhere on the board
/STM32/MUX1_COMS: D1105.2 (A); also elsewhere on the board
/STM32/MUX2_COMS: D1108.2 (A); also elsewhere on the board
/STM32/OT: D1106.2 (A); also elsewhere on the board
/STM32/OV: D1101.2 (A); also elsewhere on the board
/STM32/USB_C_COMS: D1112.2 (A); also elsewhere on the board
/STM32/UT: D1109.2 (A); also elsewhere on the board
/STM32/UV: D1104.2 (A); also elsewhere on the board
GND: R1101.2, R1102.2, R1103.2, R1104.2, R1105.2, R1106.2, R1107.2, R1108.2, R1109.2, R1110.2, R1111.2, R1112.2; also elsewhere on the board
unnamed: D1101.1 (K), R1101.1
unnamed: D1102.1 (K), R1102.1
unnamed: D1103.1 (K), R1103.1
unnamed: D1104.1 (K), R1104.1
unnamed: D1105.1 (K), R1105.1
unnamed: D1106.1 (K), R1106.1
unnamed: D1107.1 (K), R1107.1
unnamed: D1108.1 (K), R1108.1
unnamed: D1109.1 (K), R1109.1
unnamed: D1110.1 (K), R1110.1
unnamed: D1111.1 (K), R1111.1
unnamed: D1112.1 (K), R1112.1

Notes on the sheet:
Heartbeat in code

Board: 4 copper layers, 316 parts (0 on the bottom side), 181 nets, no tracks yet.

Other parts of the board:
kibuzzard-68FE96E6: G***; kibuzzard-68FE96E6
kibuzzard-68FE9694: G***; kibuzzard-68FE9694
kibuzzard-68FE9708: G***; kibuzzard-68FE9708
