Eemac/OlinBAD/Hardware/Power Board/Power Board.kicad_pcb

## KiCad design Hardware/Power Board/Power Board.kicad_pcb (2025-10-29)

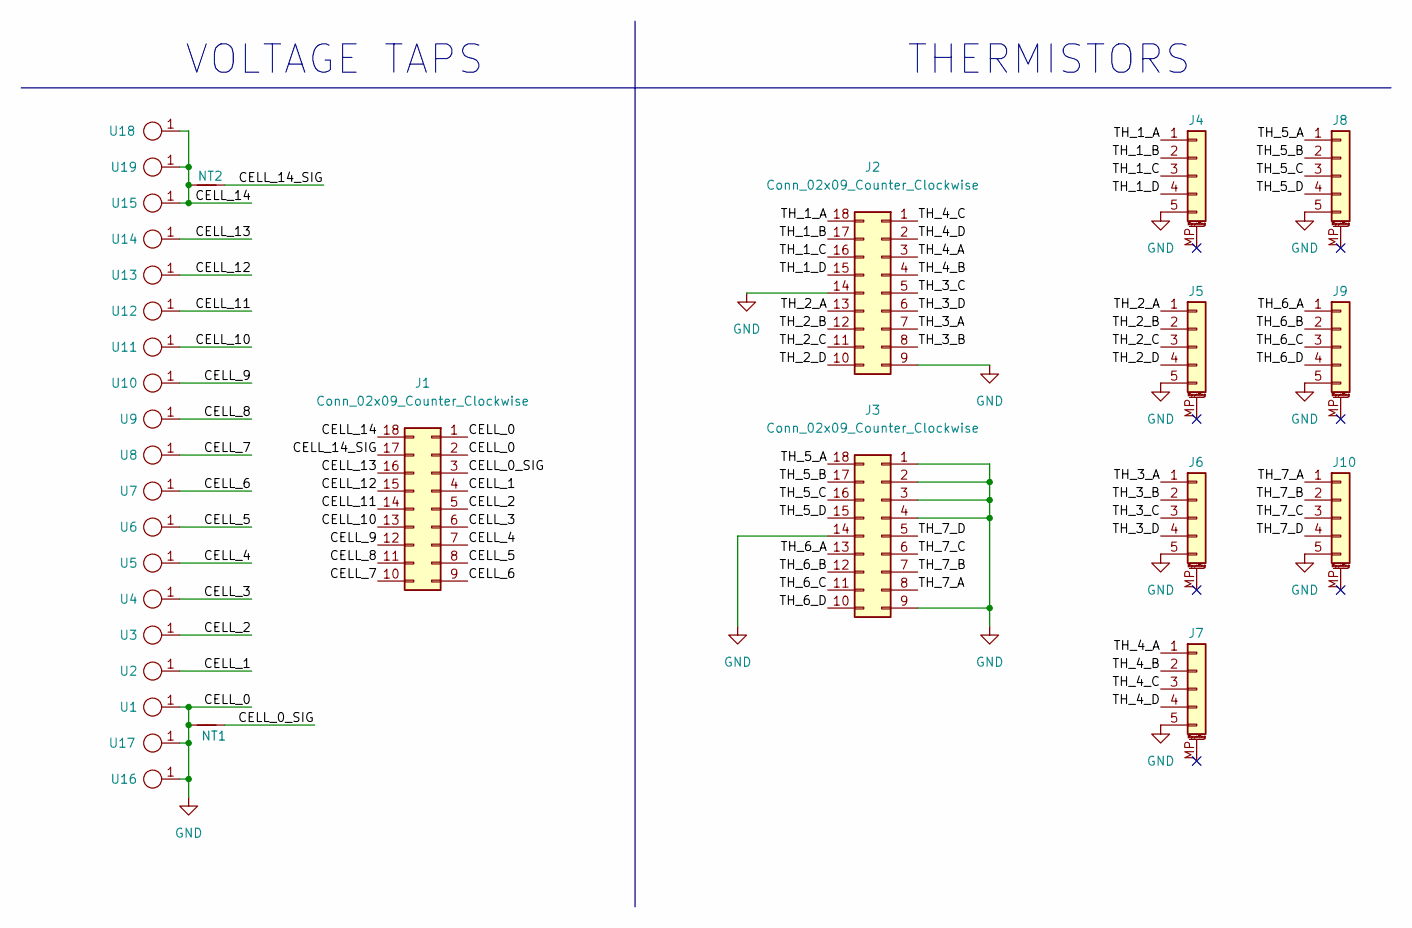
[picture p13: schematic Power Board.kicad_sch, B.A.D. Power Board]

Parts:
J1, J2, J3: Conn_02x09_Counter_Clockwise; PinSocket_2x09_P2.54mm_Vertical
J4, J5, J6, J7, J8, J9, J10: Conn_01x05_MountingPin; TE_0-1734839-5_1x05-1MP_P0.5mm_Horizontal
NT1, NT2: NetTie_2; NetTie-2_SMD_Pad0.5mm
U1, U2, U3, U4, U5, U6, U7, U8, U9, U10, U11, U12, U13, U14, U15: BatteryTab
U16, U17, U18, U19: 7461098

Connections:
/CELL_0_SIG: J1.3, NT1.2
/CELL_1: J1.4, U2.1
/CELL_2: J1.5, U3.1
/CELL_3: J1.6, U4.1
/CELL_4: J1.7, U5.1
/CELL_5: J1.8, U6.1
/CELL_6: J1.9, U7.1
/CELL_7: J1.10, U8.1
/CELL_8: J1.11, U9.1
/CELL_9: J1.12, U10.1
/CELL_10: J1.13, U11.1
/CELL_11: J1.14, U12.1
/CELL_12: J1.15, U13.1
/CELL_13: J1.16, U14.1
/CELL_14: J1.18, NT2.2, U15.1, U18.1, U19.1
/CELL_14_SIG: J1.17, NT2.1
/TH_1_A: J2.18, J4.1
/TH_1_B: J2.17, J4.2
/TH_1_C: J2.16, J4.3
/TH_1_D: J2.15, J4.4
/TH_2_A: J2.13, J5.1
/TH_2_B: J2.12, J5.2
/TH_2_C: J2.11, J5.3
/TH_2_D: J2.10, J5.4
/TH_3_A: J2.7, J6.1
/TH_3_B: J2.8, J6.2
/TH_3_C: J2.5, J6.3
/TH_3_D: J2.6, J6.4
/TH_4_A: J2.3, J7.1
/TH_4_B: J2.4, J7.2
/TH_4_C: J2.1, J7.3
/TH_4_D: J2.2, J7.4
/TH_5_A: J3.18, J8.1
/TH_5_B: J3.17, J8.2
/TH_5_C: J3.16, J8.3
/TH_5_D: J3.15, J8.4
/TH_6_A: J3.13, J9.1
/TH_6_B: J3.12, J9.2
/TH_6_C: J3.11, J9.3
/TH_6_D: J3.10, J9.4
/TH_7_A: J3.8, J10.1
/TH_7_B: J3.7, J10.2
/TH_7_C: J3.6, J10.3
/TH_7_D: J3.5, J10.4
GND: J1.1, J1.2, J2.9, J2.14, J3.1, J3.2, J3.3, J3.4, J3.9, J3.14, J4.5, J5.5, J6.5, J7.5, J8.5, J9.5, J10.5, NT1.1, U1.1, U16.1, U17.1

Notes on the sheet:
THERMISTORS
VOLTAGE TAPS

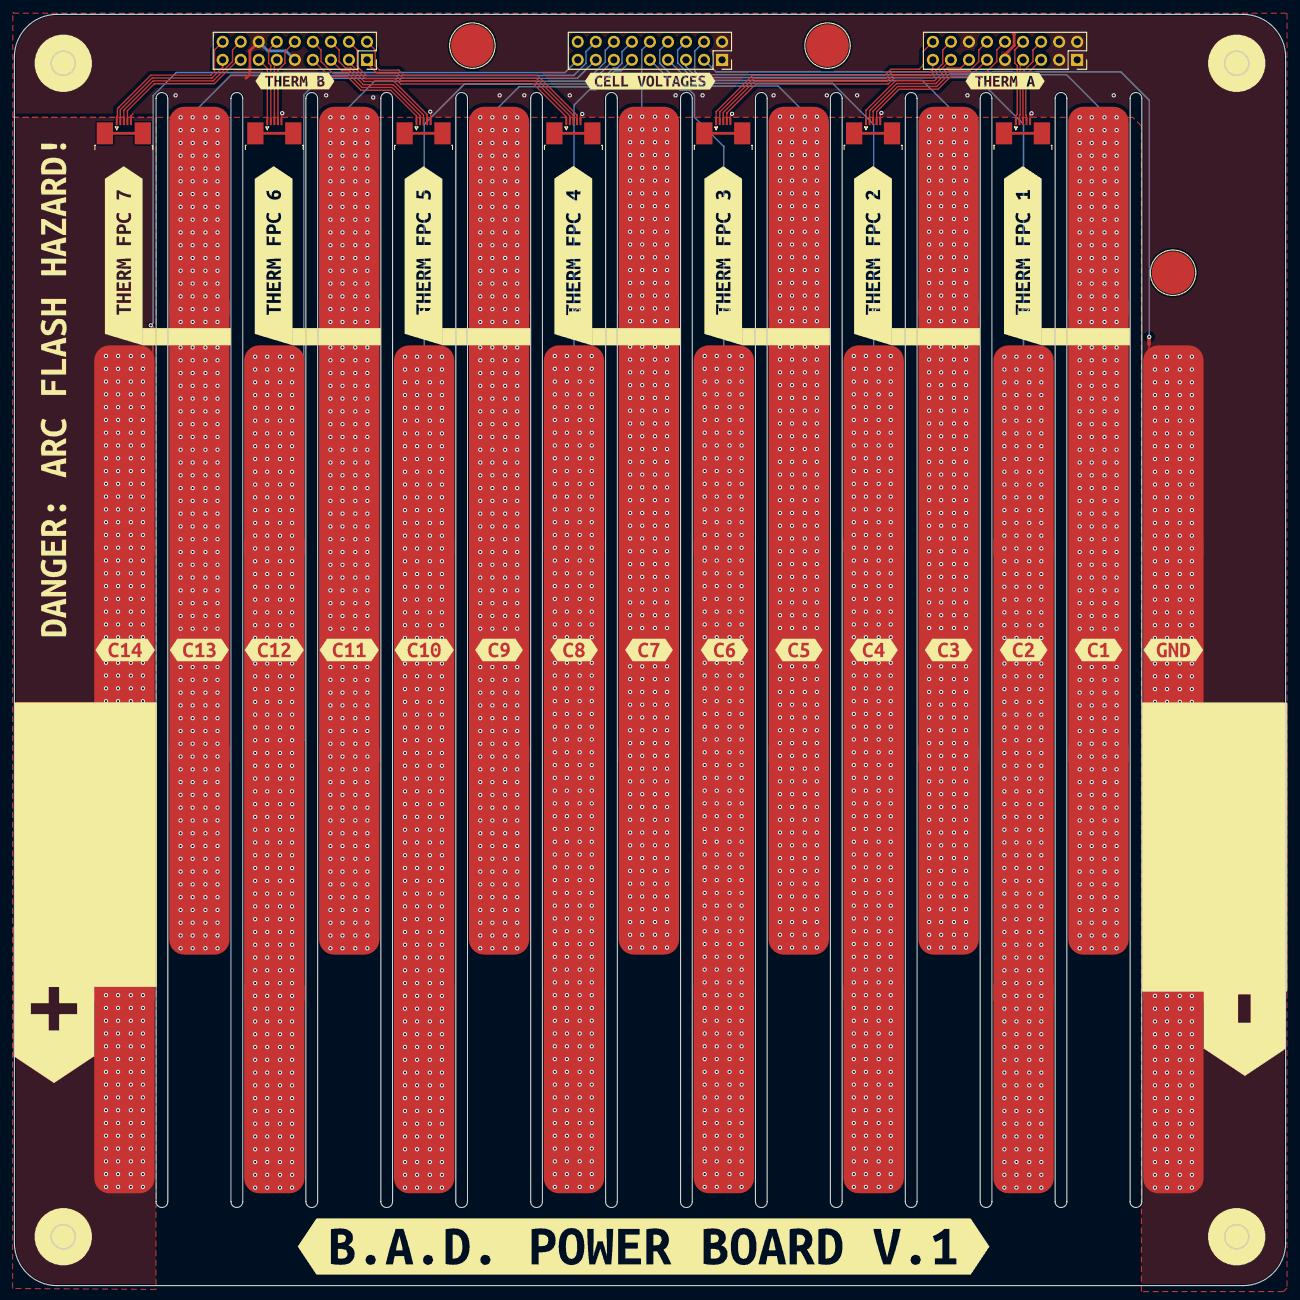
[picture p14: board Power Board.kicad_pcb from above]

Board: 2 copper layers, 179.0 x 179.0 mm, 60 parts (0 on the bottom side), 45 nets.

Other parts of the board:
kibuzzard-68FE6C25: G***; kibuzzard-68FE6C25
kibuzzard-68FE8B33: G***; kibuzzard-68FE8B33
kibuzzard-68FE8BAD: G***; kibuzzard-68FE8BAD
kibuzzard-68FE8C3A: G***; kibuzzard-68FE8C3A
kibuzzard-68FE8C6B: G***; kibuzzard-68FE8C6B
kibuzzard-68FE8C6F: G***; kibuzzard-68FE8C6F
kibuzzard-68FE8C7B: G***; kibuzzard-68FE8C7B
kibuzzard-68FE8C8C: G***; kibuzzard-68FE8C8C
kibuzzard-68FE8C9C: G***; kibuzzard-68FE8C9C
kibuzzard-68FE8C40: G***; kibuzzard-68FE8C40
kibuzzard-68FE8C46: G***; kibuzzard-68FE8C46
kibuzzard-68FE8C51: G***; kibuzzard-68FE8C51
kibuzzard-68FE8C58: G***; kibuzzard-68FE8C58
kibuzzard-68FE8C80: G***; kibuzzard-68FE8C80
kibuzzard-68FE8C86: G***; kibuzzard-68FE8C86
kibuzzard-68FE8C91: G***; kibuzzard-68FE8C91
kibuzzard-68FE8C96: G***; kibuzzard-68FE8C96
kibuzzard-68FE9A02: G***; kibuzzard-68FE9A02
kibuzzard-68FE96E6: G***; kibuzzard-68FE96E6
kibuzzard-68FE971D: G***; kibuzzard-68FE971D
kibuzzard-68FE972D: G***; kibuzzard-68FE972D
kibuzzard-68FE9694: G***; kibuzzard-68FE9694
kibuzzard-68FE9708: G***; kibuzzard-68FE9708
kibuzzard-68FE9722: G***; kibuzzard-68FE9722
kibuzzard-68FE9727: G***; kibuzzard-68FE9727
kibuzzard-68FE9731: G***; kibuzzard-68FE9731
kibuzzard-68FE9739: G***; kibuzzard-68FE9739
kibuzzard-68FE9876: G***; kibuzzard-68FE9876
kibuzzard-68FEE0E1: G***; kibuzzard-68FEE0E1
