Eemac/OlinBAD/Hardware/PowerFet/HIghSidePowerFET.kicad_pcb

## KiCad design Hardware/PowerFet/HIghSidePowerFET.kicad_pcb (2025-10-27)

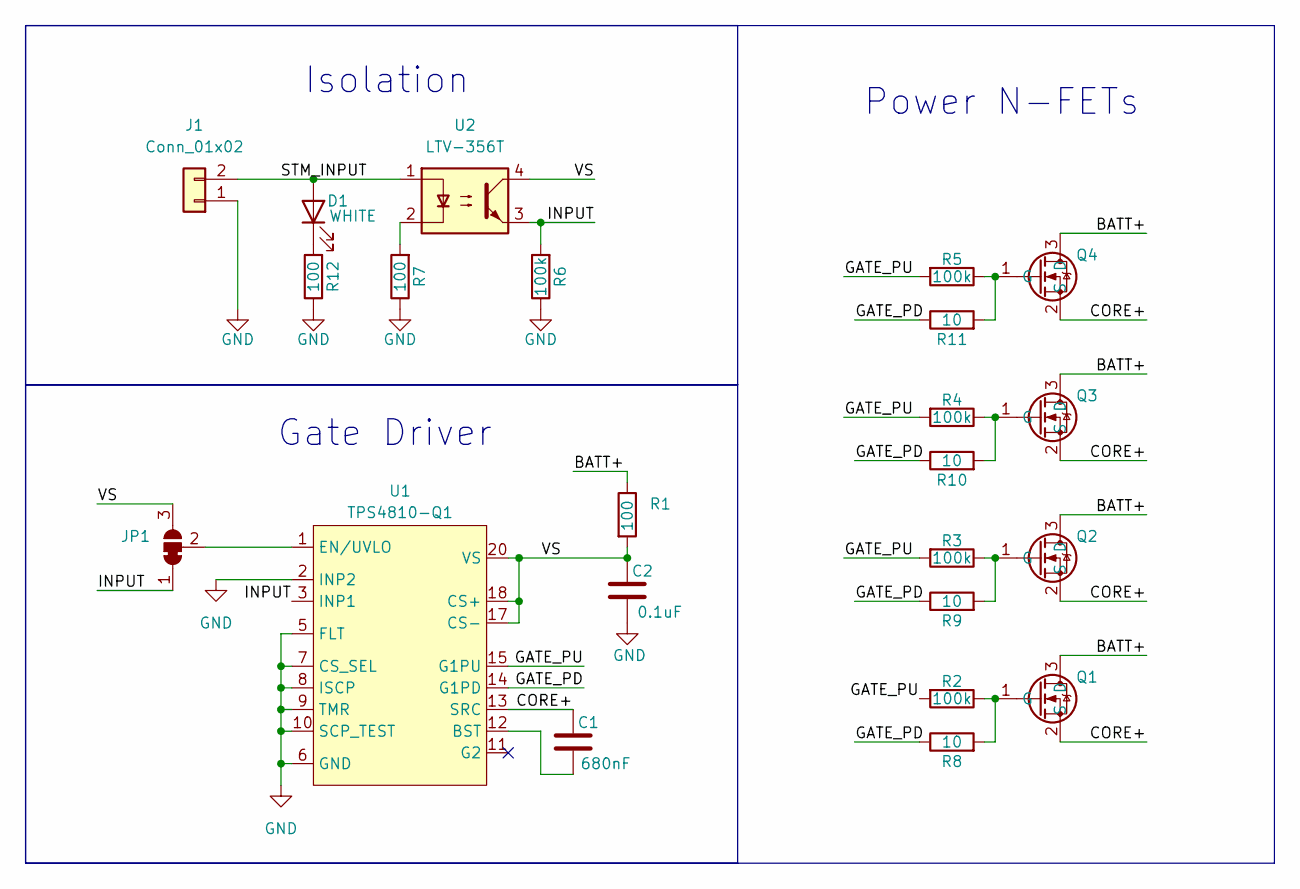
[picture p15: schematic HIghSidePowerFET.kicad_sch, 300A Pack Breaker]

Parts:
C1: 680nF; C_0603_1608Metric
C2: 0.1uF; C_0603_1608Metric
D1: WHITE; LED_0805_2012Metric
J1: Conn_01x02; Molex_Nano-Fit_105313-xx02_1x02_P2.50mm_Horizontal
JP1: SolderJumper_3_Bridged12; SolderJumper-3_P1.3mm_Bridged12_RoundedPad1.0x1.5mm
Q1, Q2, Q3, Q4: NTBLS0D8N08X
R1: 100; R_0805_2012Metric
R2, R3, R4, R5, R6: 100k; R_0603_1608Metric
R7, R12: 100; R_0603_1608Metric
R8, R9, R10, R11: 10; R_0603_1608Metric
U1: TPS4810-Q1; VSSOP-19
U2: LTV-356T; SO-4_4.4x3.6mm_P2.54mm

Connections:
/BATT+: Q1.3 (D), Q2.3 (D), Q3.3 (D), Q4.3 (D), R1.1
/CORE+: C1.2, Q1.2 (S), Q2.2 (S), Q3.2 (S), Q4.2 (S), U1.13 (SRC)
/GATE_PD: R8.1, R9.1, R10.1, R11.1, U1.14 (G1PD)
/GATE_PU: R2.2, R3.2, R4.2, R5.2, U1.15 (G1PU)
/INPUT: JP1.1 (A), R6.2, U1.3 (INP1), U2.3
/STM_INPUT: D1.2 (A), J1.2, U2.1
/VS: C2.2, JP1.3 (B), R1.2, U1.17 (CS-), U1.18 (CS+), U1.20 (VS), U2.4
GND: C2.1, J1.1, R6.1, R7.1, R12.1, U1.2 (INP2), U1.5 (FLT), U1.6 (GND), U1.7 (CS_SEL), U1.8 (ISCP), U1.9 (TMR), U1.10 (SCP_TEST)
unnamed: D1.1 (K), R12.2
unnamed: JP1.2 (C), U1.1 (EN/UVLO)
unnamed: Q1.1 (G), R2.1, R8.2
unnamed: Q2.1 (G), R3.1, R9.2
unnamed: Q3.1 (G), R4.1, R10.2
unnamed: Q4.1 (G), R5.1, R11.2
unnamed: R7.2, U2.2
unnamed: C1.1, U1.12 (BST)

Notes on the sheet:
Power N-FETs
Gate Driver
Isolation

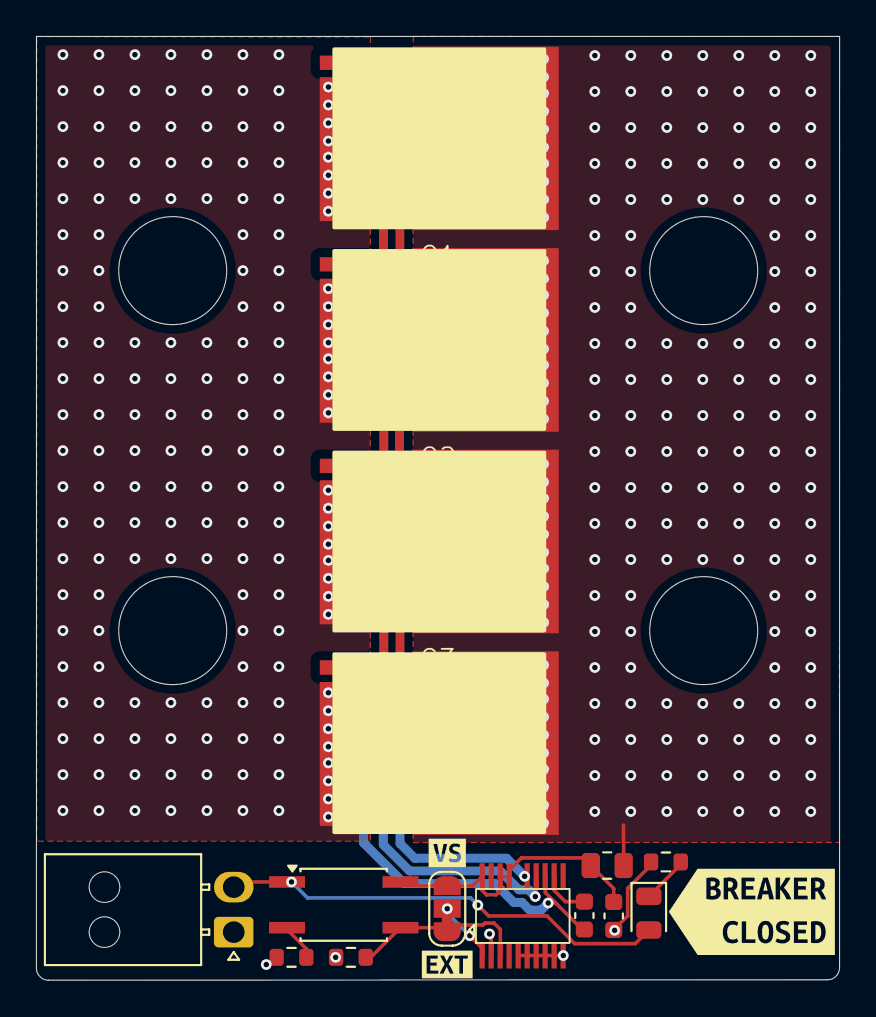
[picture p16: board HIghSidePowerFET.kicad_pcb from above]

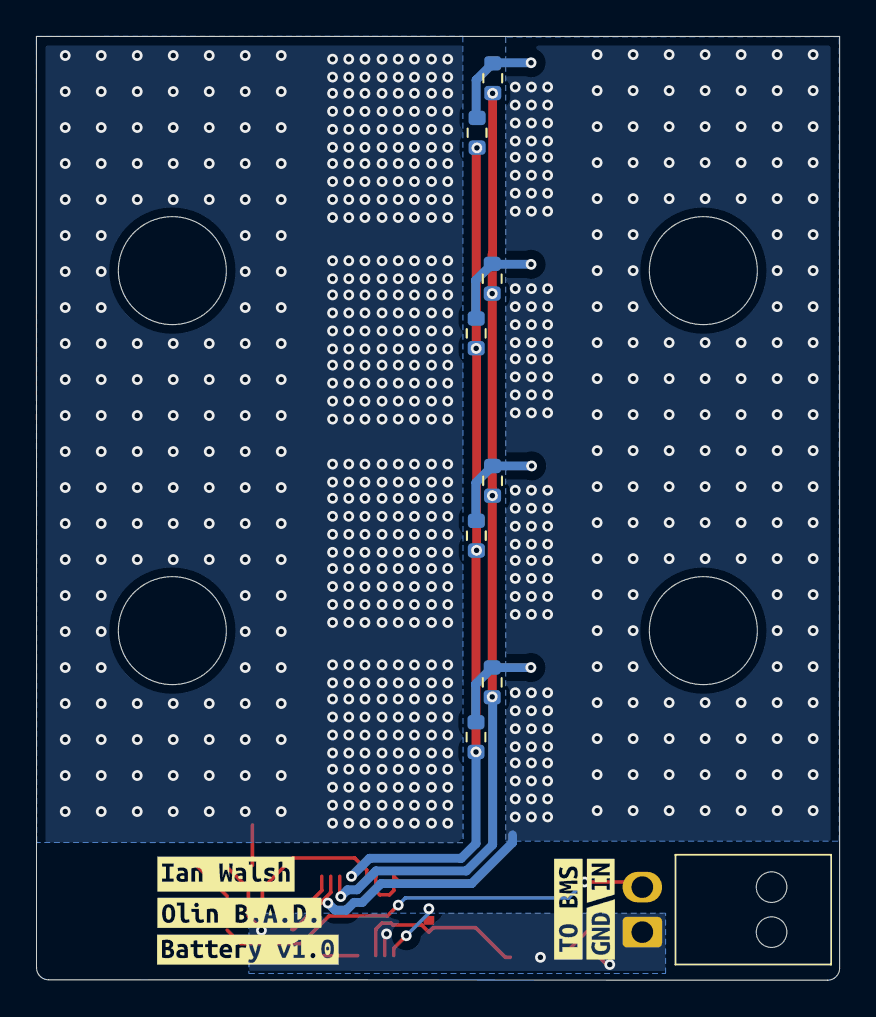
[picture p17: board HIghSidePowerFET.kicad_pcb from below]

Board: 2 copper layers, 44.6 x 52.4 mm, 32 parts (14 on the bottom side), 16 nets.

Other parts of the board:
kibuzzard-68F7A0AD: G***; kibuzzard-68F7A0AD
kibuzzard-68F7A0C5: G***; kibuzzard-68F7A0C5
kibuzzard-68F7A12F: G***; kibuzzard-68F7A12F
kibuzzard-68F7ACD6: G***; kibuzzard-68F7ACD6
kibuzzard-68F7AD8A: G***; kibuzzard-68F7AD8A
kibuzzard-68F7ADA7: G***; kibuzzard-68F7ADA7
kibuzzard-68F7D5F0: G***; kibuzzard-68F7D5F0
kibuzzard-68F79DB8: G***; kibuzzard-68F79DB8
kibuzzard-68F79DC8: G***; kibuzzard-68F79DC8
