Eemac/OlinBAD/(commit log)

2025-10-08 added kicad lib files
2025-10-10 adding formula symbol lib + oem.pretty + formula.pretty + 6 pin molex RA connectors
    [1-776266-1.step, 1-776276-1.step, 1-776279-1.step, 100SP1T1B4M2QE.step, 194270032.step, 2-1761465-1 2.step, 2-1761465-1.step, 2-1761465-2 2.step]
2025-10-10 associating minifit symbol with footprint and changing symbol
2025-10-10 added 4 bms connectors and unfinished stm32 peripherals subsheet draft
    [flight-core.kicad_pcb, flight-core.kicad_sch, stm32.kicad_sch]
2025-10-27 power + fet baord added
    [1-776266-1.step, 1-776276-1.step, 1-776279-1.step, 100SP1T1B4M2QE.step, 194270032.step, 2-1761465-1 2.step, 2-1761465-1.step, 2-1761465-2 2.step]
2025-10-29 edits to the BMS
    [ADBMS1818.kicad_sch, bms.kicad_sch, cell_balancing.kicad_sch, filter_balance.kicad_sch, power.kicad_sch, thermistors.kicad_sch]
2025-10-29 added can transciever
    [bms.kicad_sch]
2025-10-29 updated some stm stuff and added current sense amplifier for main pack
    [Power Board.kicad_pcb, bms.kicad_sch, stm32.kicad_sch, thermistors.kicad_sch]
2025-10-29 added df17 part to library, added stm32 actual names of pins
    [DF17_4.0_-80DP-0.5V_57_.step, buck_60_19.kicad_sch, flight-core.kicad_sch, stm32.kicad_sch]
2025-10-29 adding cube connector
    [cubeconnect.kicad_sch, flight-core.kicad_sch, stm32.kicad_sch]
2025-10-29 Add test points and LEDs
    [ADBMS1818.kicad_sch, bms.kicad_sch, cell_tps.kicad_sch, leds.kicad_sch, stm32.kicad_sch, therm_tps.kicad_sch, thermistors.kicad_sch]
2025-10-31 added gitignore to get rid of extra kicad files
2025-10-31 begin layout
    [ADBMS1818.kicad_sch, bms.kicad_pcb, bms.kicad_sch, cell_tps.kicad_sch, filter_balance.kicad_sch, leds.kicad_sch, power.kicad_sch, stm32.kicad_sch]
2025-11-01 some pcb layout
    [bms.kicad_pcb]
2025-11-01 Initial Thermistor geo
    [Thermistors.kicad_pcb, Thermistors.kicad_sch]
2025-11-01 adding logic gate and cube orange footprints to obad lib
